Sirawit7205/Autoplanter/20171114_222624.jpg

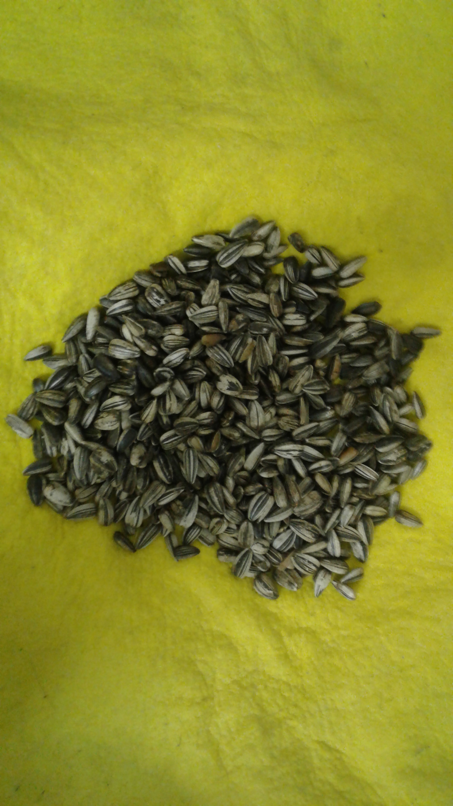
20171114_222624.jpg
