Sirawit7205/Autoplanter/README.md

Autoplanter - Automatic Sunflower Sprout Planter project

For Subject CPE101
