Sirawit7205/Autoplanter/3d_version2/draft2.docx

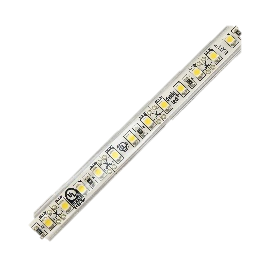
[picture p3: figure]
ผลการค้นหารูปภาพสำหรับ led strip

Water pump

LED strips

Water pipes

User interface & Control box

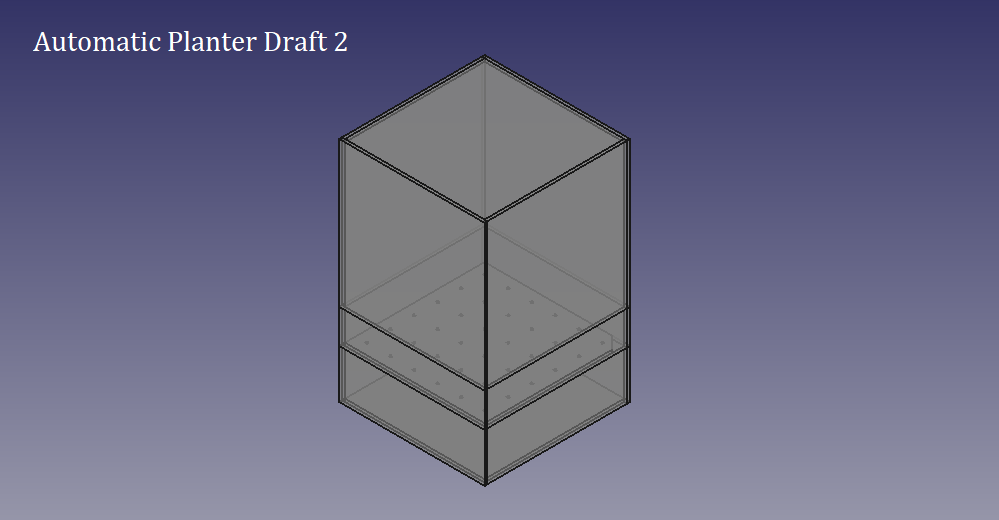
[picture p4: figure]

Water reservoir

Planter tray

Cover

30 cm

30 cm

10 cm

7 cm

30 cm
