Sirawit7205/Autoplanter/exploration3_2.pdf

05/12/60

1

# โครงงาน

## เครือÉ งปลูกต้นอ่อนทานตะวนั

## ·Õè»ÃÖ¡ÉÒ ÊÃÃ ÃÑµ¹ÊÑÒ ¸¹à´ª ÈÃÕÊØ¢ÇÊØ

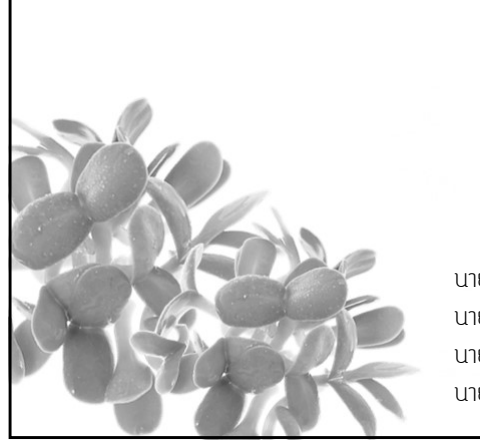
[picture p6: figure]

¹ÒÂÇ§È¸Ã â¡ÊÕÂÐ¡ØÅ | 60070501051
¹ÒÂÀÙÁÔÀÑ·Ã »ÒÅ¡ÐÇ§È ³ ÍÂØ¸ÂÒ 60070501044
¹ÒÂÇÈÔ¹ àÈÃÉ°âª´Ö¡ | 60070501054
¹ÒÂÊÔÃÇÔª ÅÒÀ¾ÔàÈÉ¾Ñ¹¸Ø | 60070501064

# ความเป็นมาและความสาํ คญั ของโครงงาน

## - ÊÔè§ÃÍºµÑÇ

2

## - ¤ÇÒÁÊÒÁÒÃ¶¢Í§ÊÁÒªÔ¡

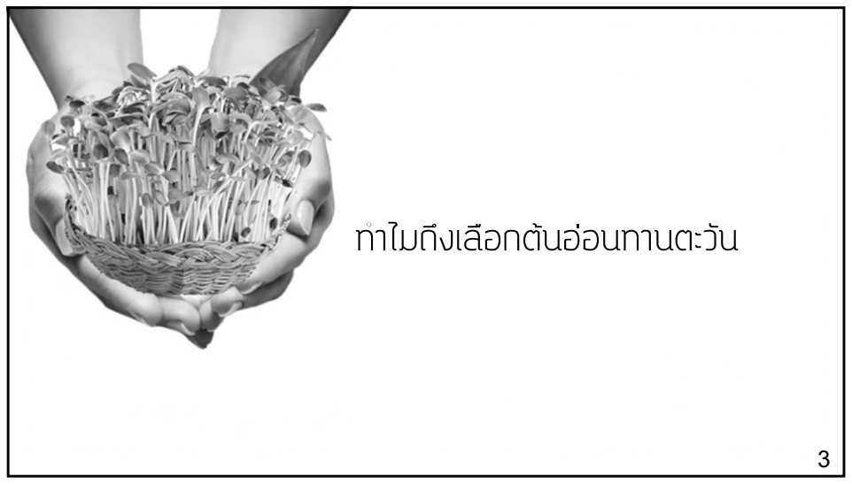
[picture p7: figure]
·íÒäÁ¶Ö§àÅ×Í¡µ ¹Í Í¹·Ò¹µÐÇÑ¹

4

## ÇÔ¸Õ¡ÒÃ»ÅÙ¡µ ¹Í Í¹·Ò¹µÐÇÑ¹·ÑèÇä»

1. áª ¹éíÒà» ¹àÇÅÒ 4-6 ªÁ.

## 2. âÃÂàÁÅç´Å§´¹Ô 3. Ã´¹éíÒÇÑ¹ÅÐ 2 ¤ÃÑé§ àª Ò-àÂç¹

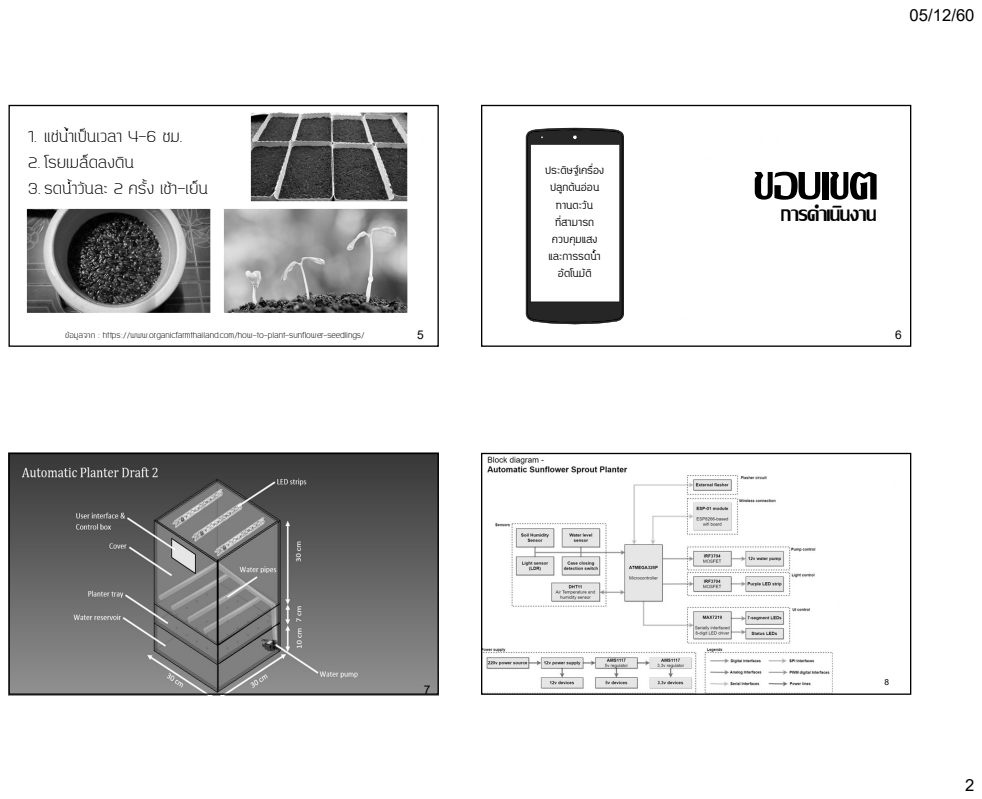
[picture p8: page 2]

ขอบเขต
การดาํ เนนิงาน

·Ò¹µÐÇÑ¹
·ÕèÊÒÁÒÃ¶
¤Çº¤ØÁáÊ§
áÅÐ¡ÒÃÃ´¹éíÒ
ÍÑµâ¹ÁÑµÔ

¢ ÍÁÙÅ¨Ò¡ : https://www.organicfarmthailand.com/how-to-plant-sunflower-seedlings/

3

# คุณลกัษณะของเครองÉื

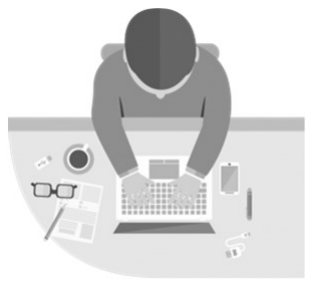
[picture p9: figure]

¡ÒÃÃ´¹Òé ÍÑµâ¹ÁÑµÔ

¤Çº¤ØÁáÊ§
ÍÑµâ¹ÁÑµÔ
9

### ปลูกต้นอ่อนทานตะวนัอตัโนมตัิ

ÇÑ´¤ÇÒÁª×é¹
´Ô¹¡ÑºÍÒ¡ÒÈ

µÃÇ¨ÊÍº ¤ÇÒÁ¼Ô´¾ÅÒ´

¢Í§ÃÐºº | ´ÙÊ¶Ò¹Ð
¼ Ò¹ wifi

# อุปกรณ์

10

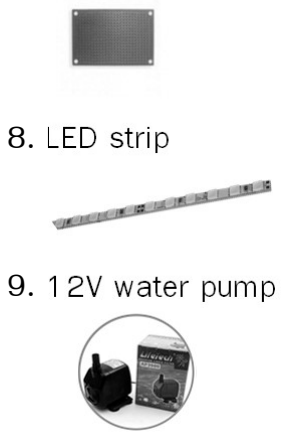
[picture p10: figure]
8. LED strip; 9. 12V water pump

## 1. ATMEGA328P

11

## 2. IRF3704

## 3. DHT111

## 4. ESP-01

## 5. AMS1117

## 6. MAX7219

12

## 7. Phenolic board 10. polycarbonate

## 11. Soil moisture sensor

## 12. Water hose

# ¡ÒÃ´íÒà¹Ô¹¡ÒÃ

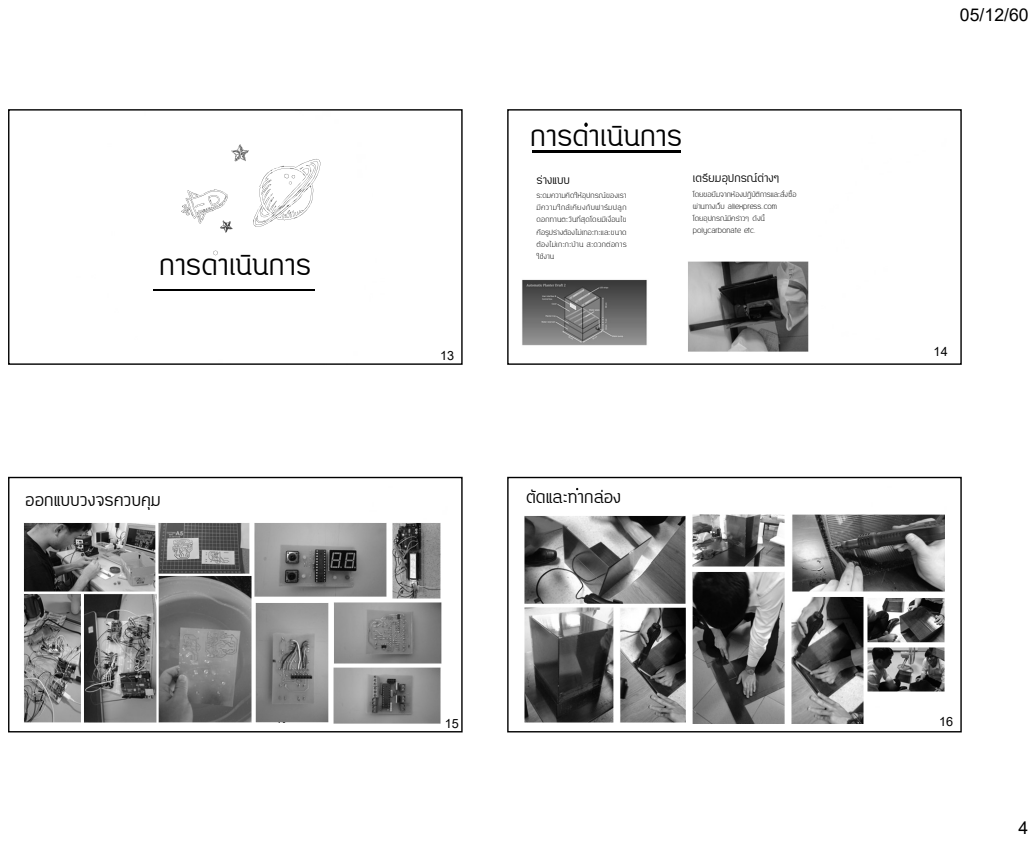
[picture p11: page 4]
ÍÍ¡áººÇ§¨Ã¤Çº¤ØÁ; µÑ´áÅÐ·íÒ¡Å Í§

Ã Ò§áºº
ÃÐ´Á¤ÇÒÁ¤Ô´ãË ÍØ»¡Ã³ ¢Í§àÃÒ
ÁÕ¤ÇÒÁã¡Å à¤ÕÂ§¡Ñº¿ÒÃ Á»ÅÙ¡
´Í¡·Ò¹µÐÇÑ¹·ÕèÊØ´â´ÂÁÕà§×èÍ¹ä¢
¤×ÍÃÙ»Ã Ò§µ Í§äÁ à·ÍÐ·ÐáÅÐ¢¹Ò´

àµÃÕÂÁÍØ»¡Ã³ µ Ò§æ
â´Â¢ÍÂ×Á¨Ò¡Ë Í§»¯®ÔºÑµÔ¡ÒÃáÅÐÊÑè§«×éÍ
¼ Ò¹·Ò§àÇçº aliexpress..com
â´ÂÍØ»¡Ã³ ÁÕ¤Ã ÒÇæ ´Ñ§¹Õé
polycarbonate etc.

¡ÒÃ´íÒà¹Ô¹¡ÒÃ

5

17

## ·´ÅÍ§»ÅÙ¡àÁÅç´·Ò¹µÐÇÑ¹

áººáª ¹éíÒ¡ Í¹áÅ Ç¤ ÍÂàÍÒÅ§´Ô¹ | áººäÁ áª ¹éíÒáÅ ÇàÍÒÅ§´Ô¹

¨Ø´»ÃÐÊ§¤ : • à»ÃÕÂºà·ÕÂº»ÃÐÊÔ·¸ÔÀÒ¾¡ÒÃ»ÅÙ¡µ ¹Í Í¹·Ò¹µÐÇÑ¹ 2 áºº
- à¾×èÍ¹íÒä»»ÃÑºãª ã¹ÃÐºº¡ÒÃ»ÅÙ¡µ ¹Í Í¹·Ò¹µÐÇÑ¹

18

## » ËÒ·Õè¾ºÃÐËÇ Ò§¡ÒÃ·íÒ§Ò¹½/¤ÇÒÁ· Ò·ÒÂ

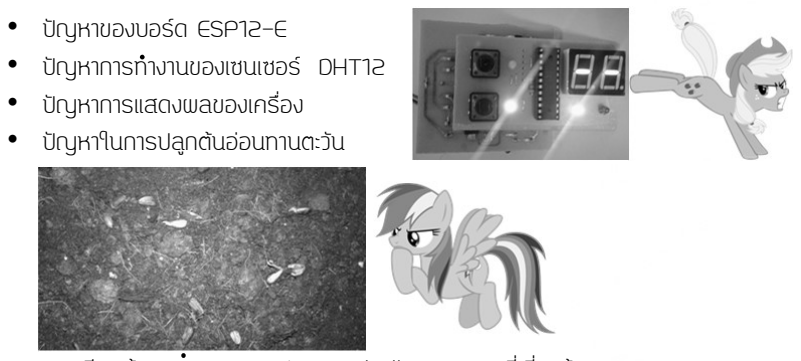
[picture p12: figure]
• » ËÒ¢Í§ºÍÃ ´ ESP12-E • » ËÒ¡ÒÃ·íÒ§Ò¹¢Í§à«¹à«ÍÃ DHT12 • » ËÒ¡ÒÃáÊ´§¼Å¢Í§à¤Ã×èÍ§ • » ËÒã¹¡ÒÃ»ÅÙ¡µ ¹Í Í¹·Ò¹µÐÇÑ¹

- ¡ÒÃàÃÕÂ¹ÃÙ ¡ÒÃ·íÒ§Ò¹¢Í§ microcontroller áÅÐÃÐºº·Õèà¡ÕèÂÇ¢ Í§
- ¤ÇÒÁäÁ ¾Ã ÍÁ¢Í§à¤Ã×èÍ§Á×Í

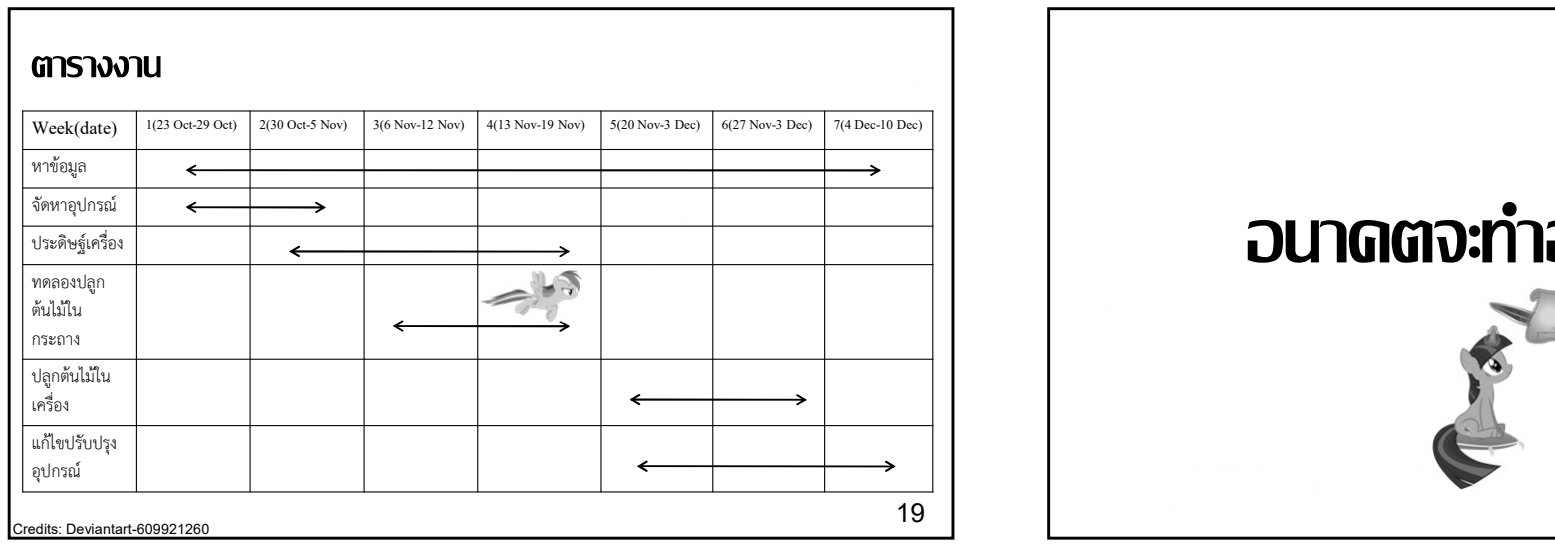
[picture p13: figure]
ตารางงาน; Week(date); 1(23 Oct-29 Oct); 2(30 Oct-5 Nov); 3(6 Nov-12 Nov); 4(13 Nov-19 Nov); 5(20 Nov-3 Dec); 6(27 Nov-3 Dec); 7(4 Dec-10 Dec); หาขอมูล จัดหาอุปกรณ ประดิษฐเครื่อง ทดลองปลูก ตนไมใน กระถาง ปลกูตนไมใน; เครื่อง แกไขปรับปรุง; อุปกรณ Credits: Deviantart-609921260; อนาคตจะทา

# อะไรต่อไป

20
