Sirawit7205/Autoplanter/box_draft1.pdf

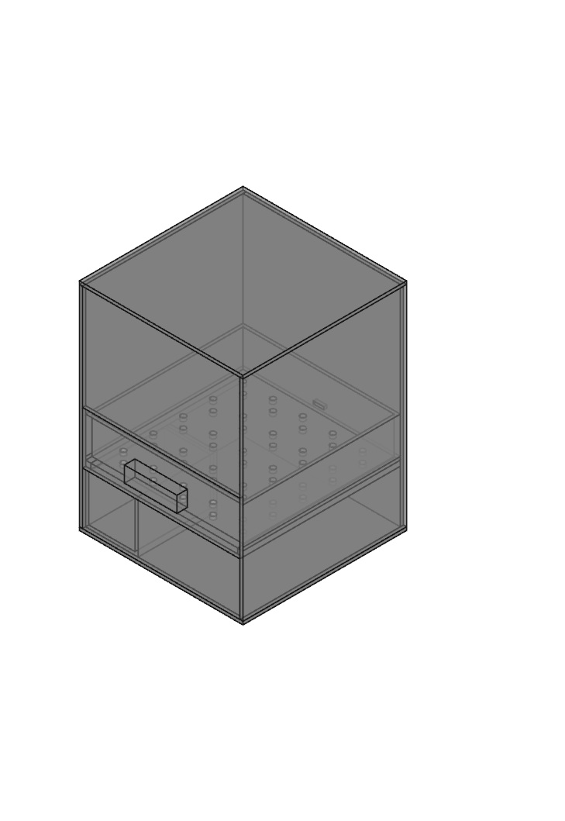
[picture p14: page 1]
