Sirawit7205/Autoplanter/exploration3.pdf

# โครงงาน

# เครื่องปลูกต้นอ่อนทานตะวัน

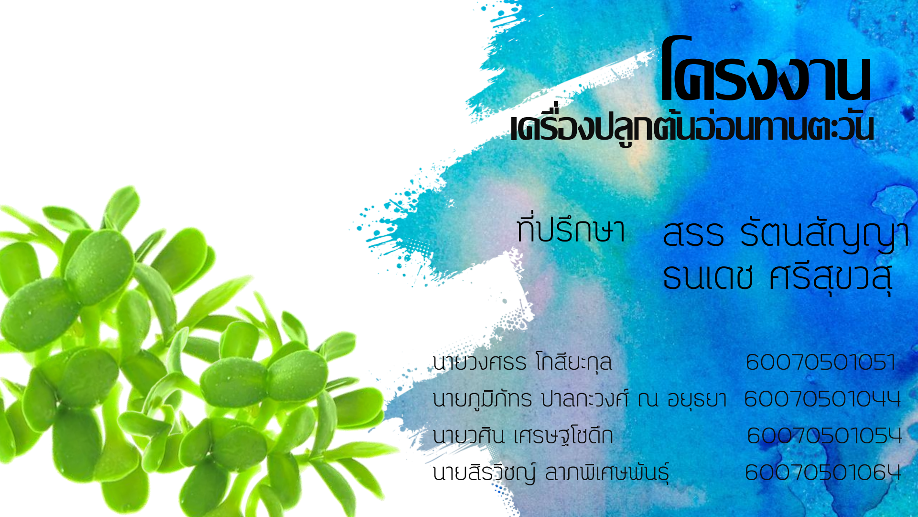
[picture p15: page 1]

## ที่ปรึกษา สรร รัตนสัญญา ธนเดช ศรีสุขวสุ

นายวงศธร โกสียะกุล | 60070501051
นายภูมิภัทร ปาลกะวงศ์ ณ อยุธยา 60070501044
นายวศิน เศรษฐโชดึก | 60070501054
นายสิรวิชญ์ ลาภพิเศษพันธุ์ | 60070501064

# ความเป็นมาและความส าคัญของโครงงาน

## - สิ่งรอบตัว - ความสามารถของสมาชิก

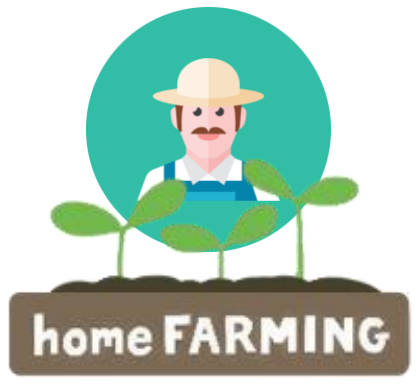
[picture p16: figure]
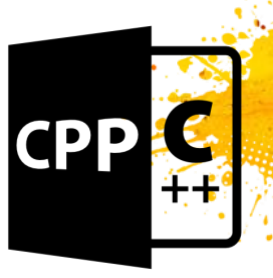
[picture p17: figure]
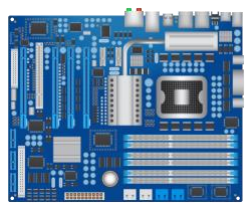
[picture p18: figure]

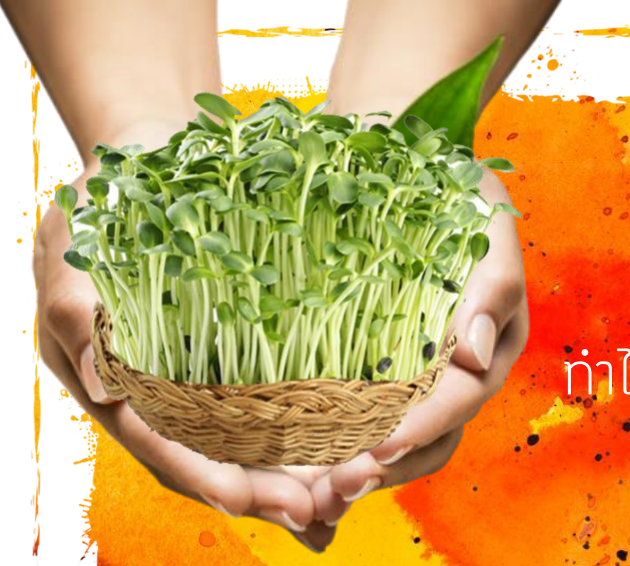
[picture p19: figure]

## ท าไมถึงเลือกต้นอ่อนทานตะวัน

## วิธีการปลูกต้นอ่อนทานตะวันทั่วไป

1. แช่น าเป็นเวลา 4-6 ชม.

## 2. โรยเมล็ดลงดิน

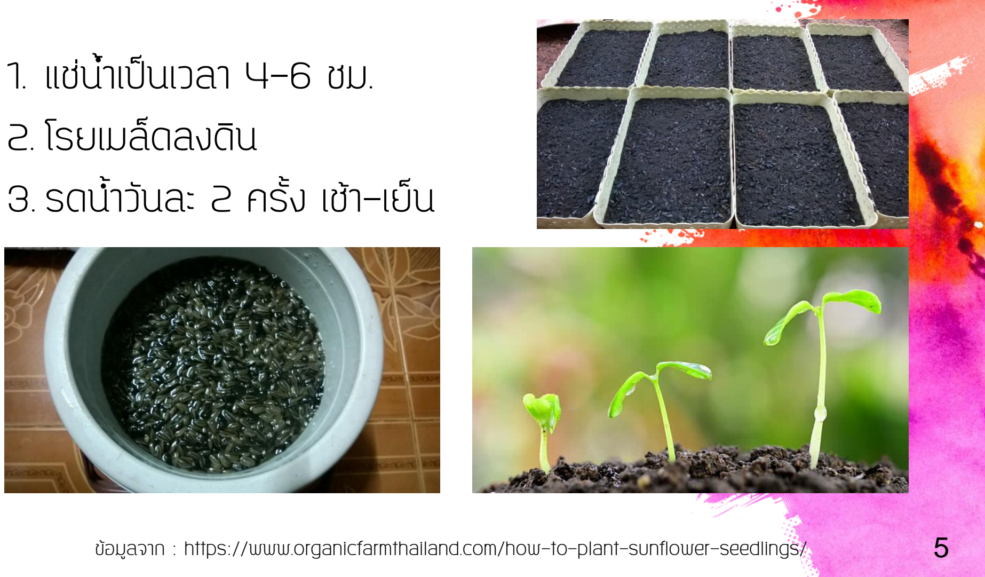
[picture p20: page 5]

## 3. รดน าวันละ 2 ครั ง เช้า-เย็น

ข้อมูลจาก : https://www.organicfarmthailand.com/how-to-plant-sunflower-seedlings/

# ขอบเขต

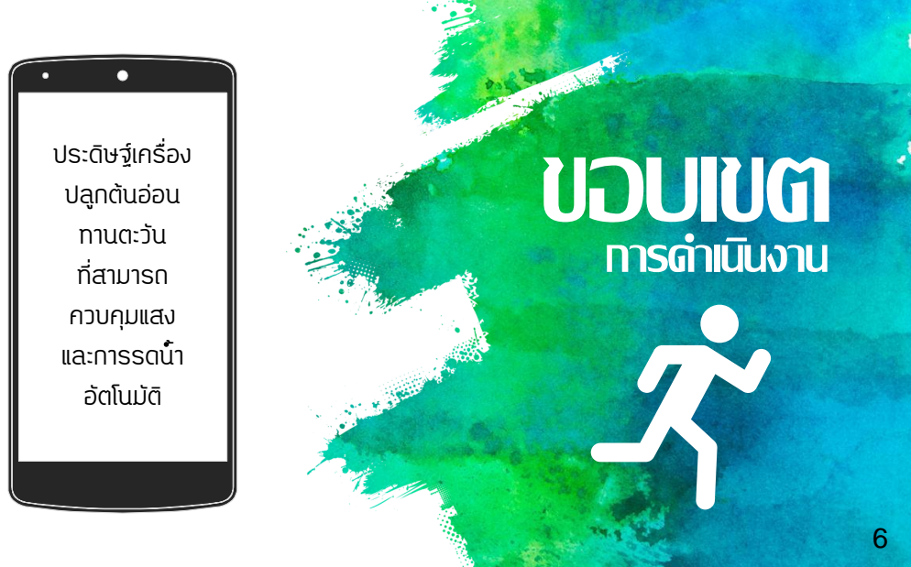
[picture p21: page 6]

ประดิษฐ์เครื่อง
ทานตะวัน
ที่สามารถ
ควบคุมแสง
และการรดน ้า
อัตโนมัติ

การด าเนินงาน

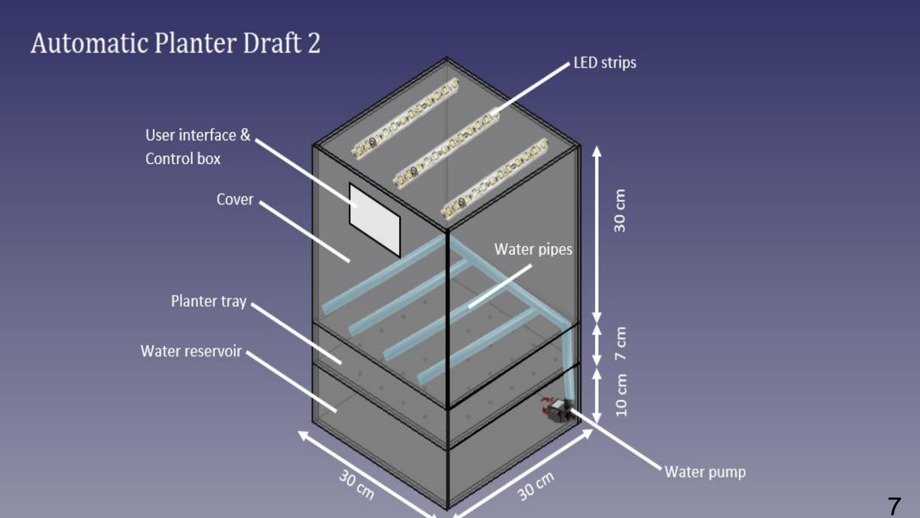
[picture p22: page 7]
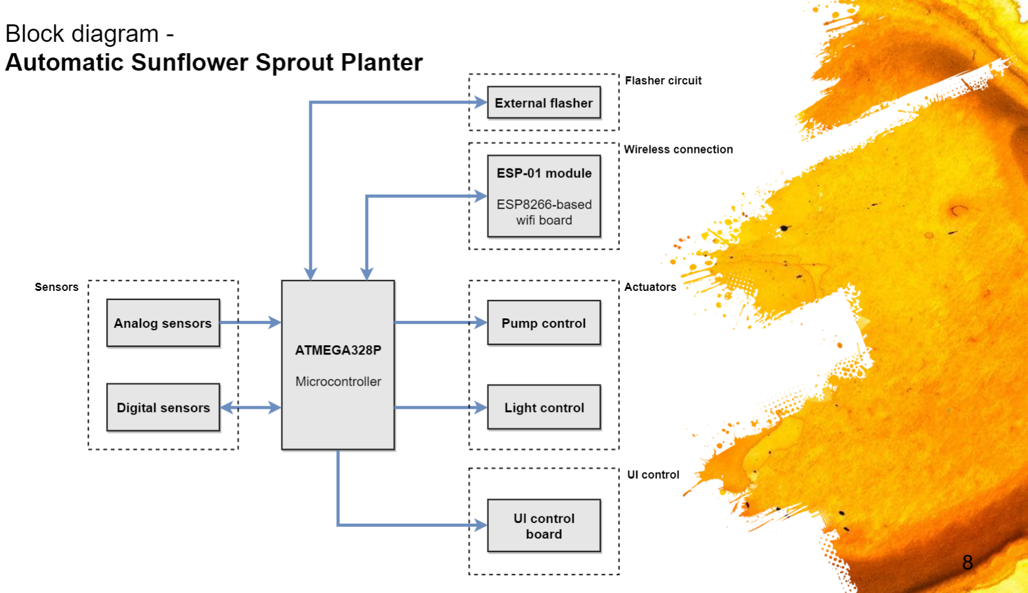
[picture p23: page 8]

# คุณลักษณะของเครื่อง

## ปลูกต้นอ่อนทานตะวันอัตโนมัติ

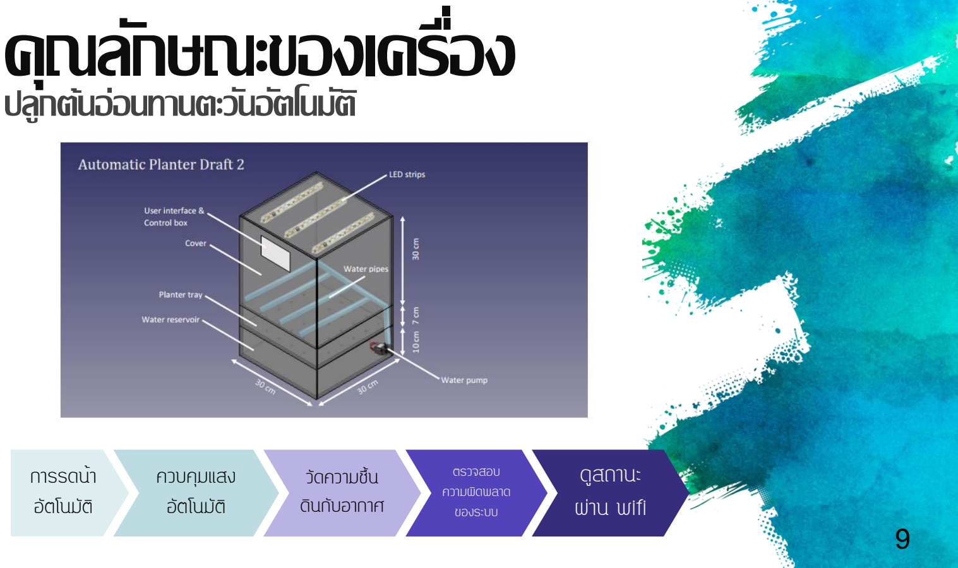
[picture p24: page 9]

การรดน า
อัตโนมัติ

ควบคุมแสง
อัตโนมัติ

วัดความชื น
ดินกับอากาศ

ตรวจสอบ
ความผิดพลาด
ของระบบ

ดูสถานะ
ผ่าน wifi

# อุปกรณ์

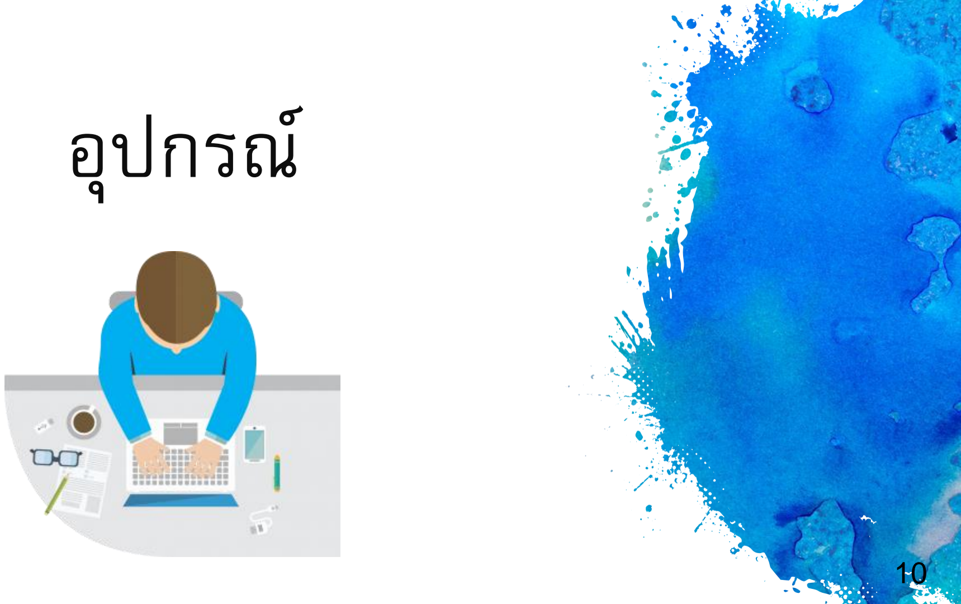
[picture p25: page 10]

### 1. ATMEGA328P

### 4. ESP-01

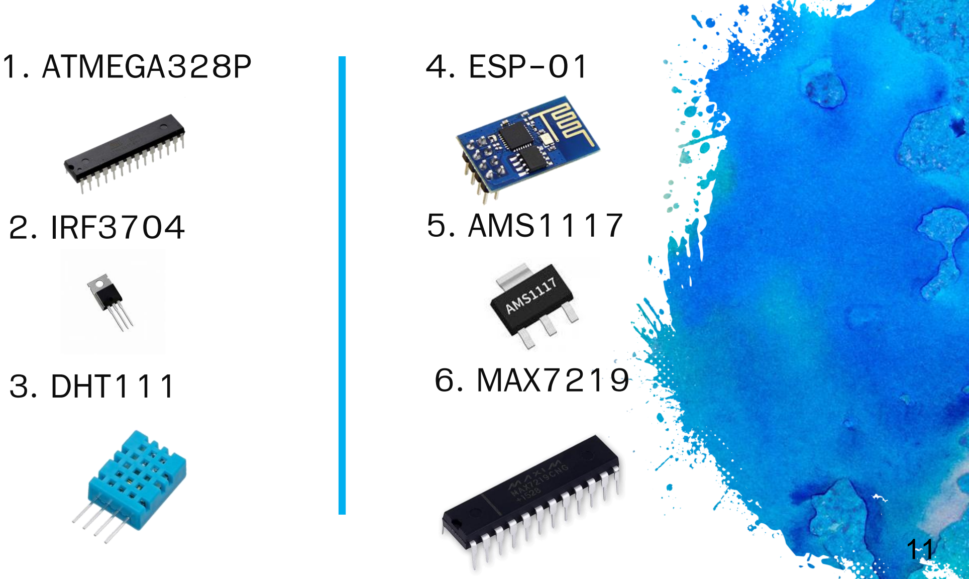
[picture p26: page 11]

### 2. IRF3704

### 3. DHT111

### 5. AMS1117

### 6. MAX7219

### 7. Phenolic board 10. polycarbonate

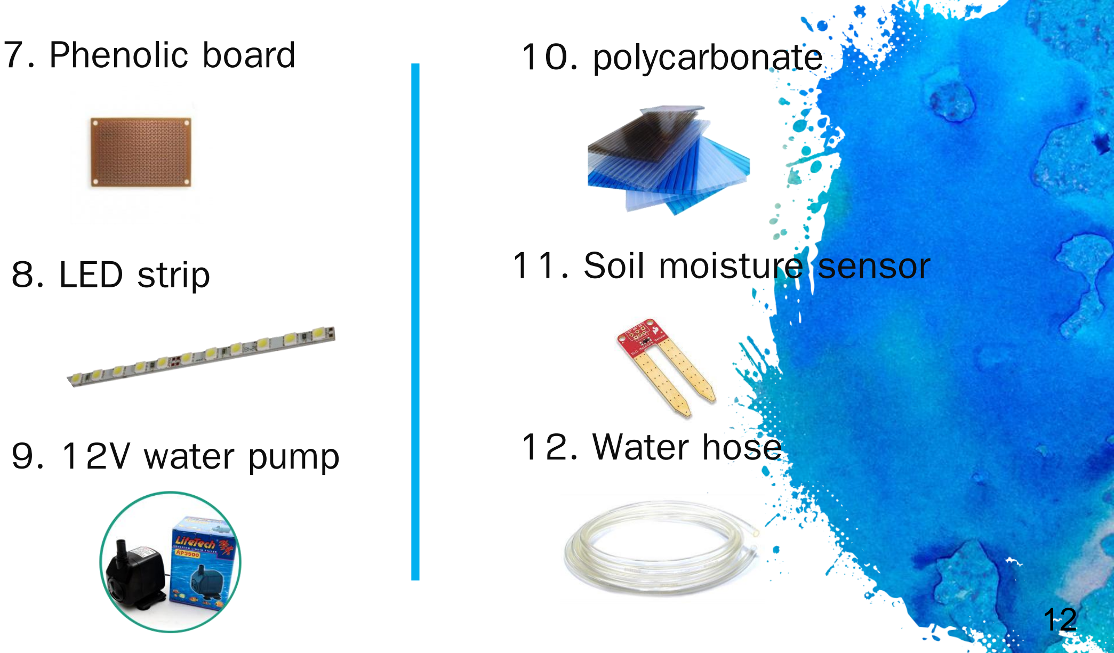
[picture p27: page 12]

### 8. LED strip

### 9. 12V water pump

### 11. Soil moisture sensor

### 12. Water hose

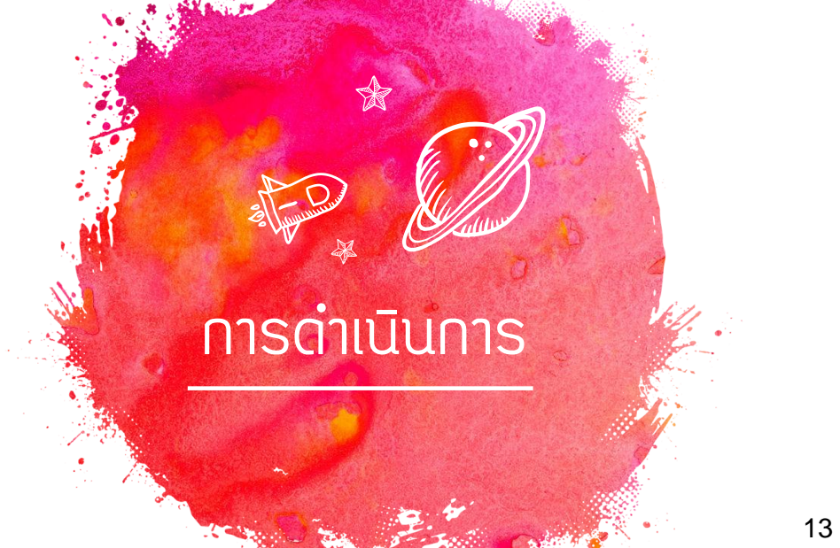
[picture p28: page 13]

การด้าเนินการ

เตรียมอุปกรณ์ต่างๆ

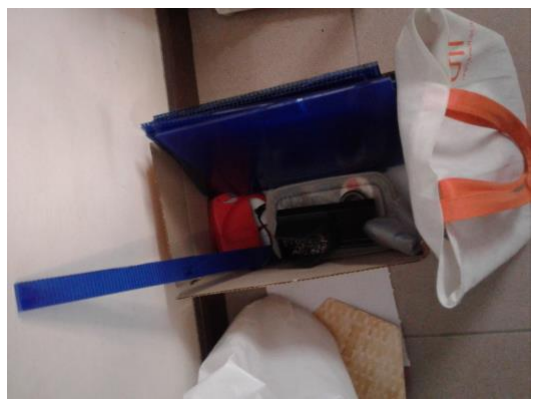
[picture p29: figure]

โดยขอยืมจากห้องปฏฎิบัติการและสั่งซื อ ผ่านทางเว็บ aliexpress..com โดยอุปกรณ์มีคร่าวๆ ดังนี
polycarbonate etc.

ร่างแบบ

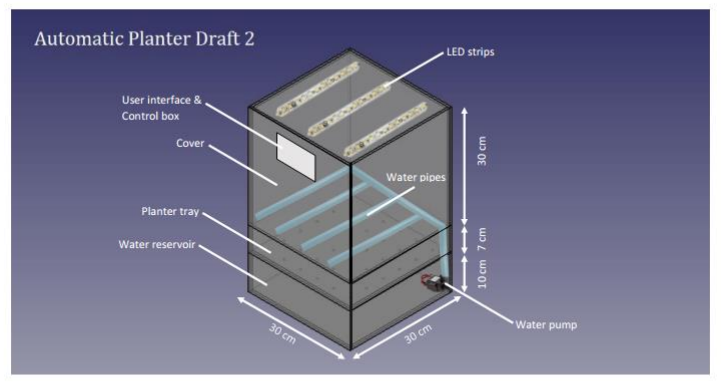
[picture p30: figure]

ระดมความคิดให้อุปกรณ์ของเรา มีความใกล้เคียงกับฟาร์มปลูก ดอกทานตะวันที่สุดโดยมีเงื่อนไข คือรูปร่างต้องไม่เทอะทะและขนาด ต้องไม่เกะกะบ้าน สะดวกต่อการ ใช้งาน

# การด้าเนินการ

## ออกแบบวงจรควบคุม

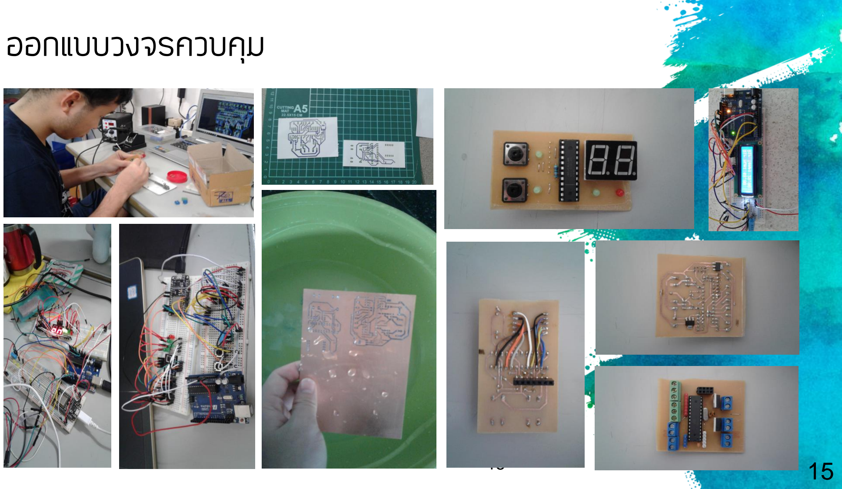
[picture p31: page 15]

15 | 15

## ตัดและท้ากล่อง กล่อง

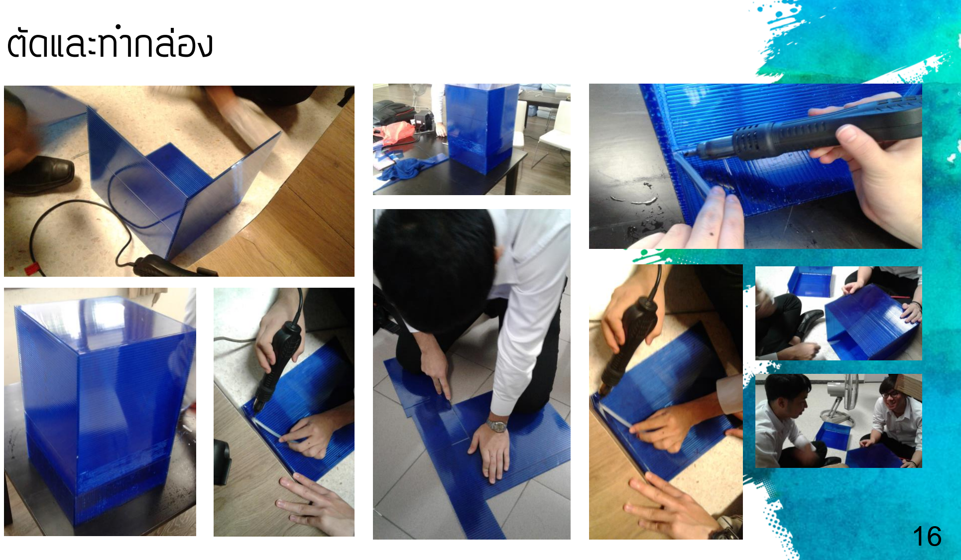
[picture p32: page 16]

## ทดลองปลูกเมล็ดทานตะวัน

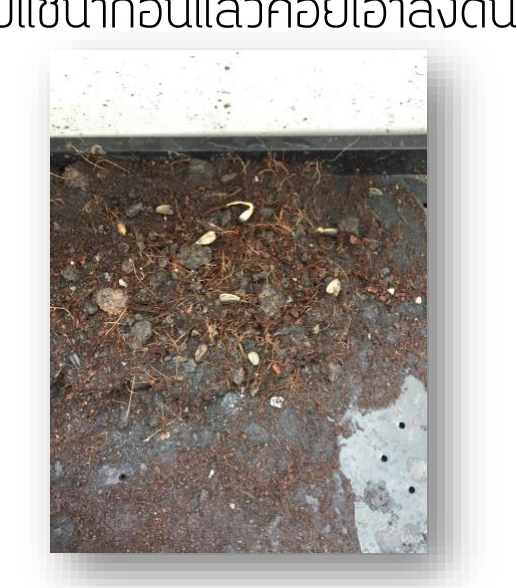
[picture p33: figure]
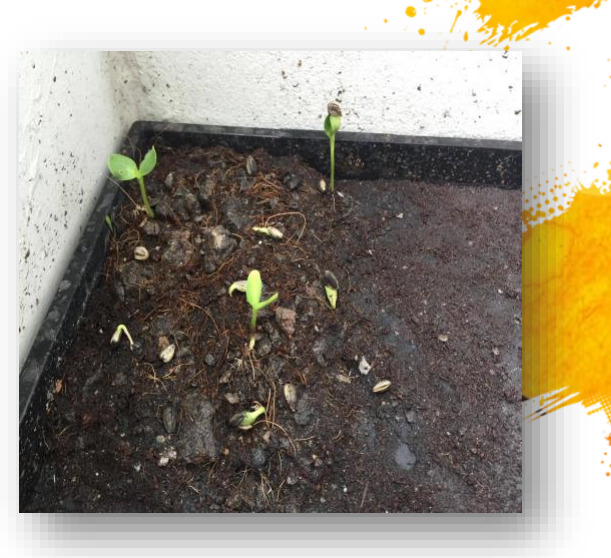
[picture p34: figure]

แบบแช่น าก่อนแล้วค่อยเอาลงดิน | แบบไม่แช่น าแล้วเอาลงดิน

จุดประสงค์ : • เปรียบเทียบประสิทธิภาพการปลูกต้นอ่อนทานตะวัน 2 แบบ
- เพื่อน าไปปรับใช้ในระบบการปลูกต้นอ่อนทานตะวัน

## ปัญหาที่พบระหว่างการท้างานฝ/ความท้าทาย

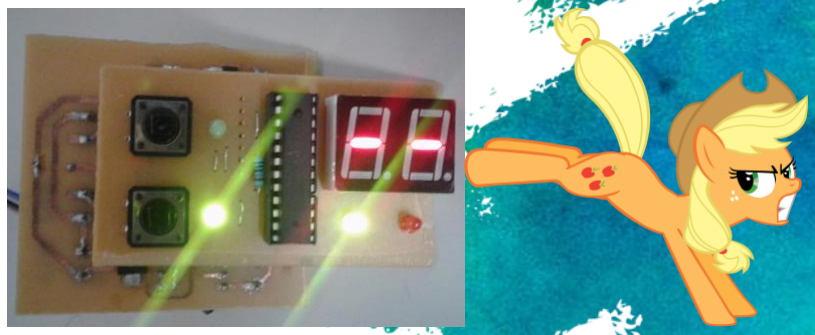
[picture p35: figure]

- ปัญหาของบอร์ด ESP12-E
- ปัญหาการท างานของเซนเซอร์ DHT12
- ปัญหาการแสดงผลของเครื่อง
- ปัญหาในการปลูกต้นอ่อนทานตะวัน

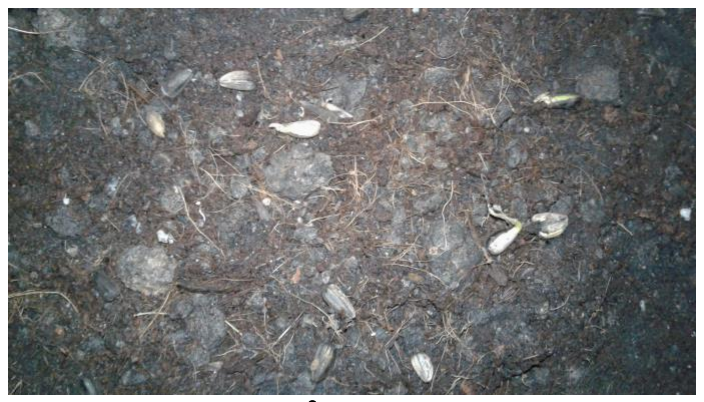
[picture p36: figure]
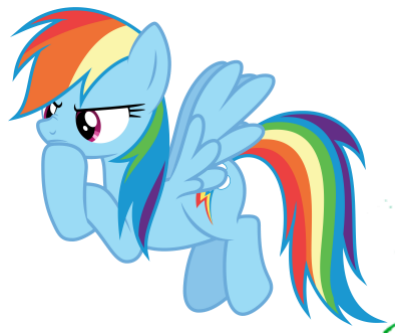
[picture p37: figure]

- การเรียนรู้การท างานของ microcontroller และระบบที่เกี่ยวข้อง
- ความไม่พร้อมของเครื่องมือ

# ตารางงาน

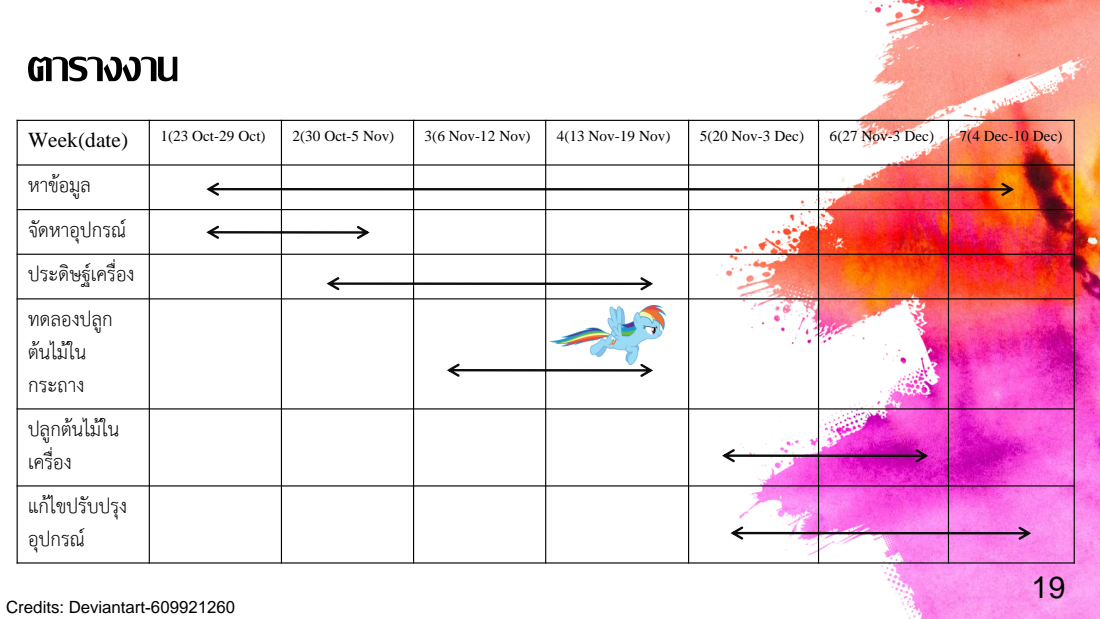
[picture p38: page 19]
Credits: Deviantart-609921260

Week(date) | 1(23 Oct-29 Oct) | 2(30 Oct-5 Nov) | 3(6 Nov-12 Nov) | 4(13 Nov-19 Nov) | 5(20 Nov-3 Dec) | 6(27 Nov-3 Dec) | 7(4 Dec-10 Dec)
หาข้อมูล
จัดหาอุปกรณ์
ประดิษฐ์เครื่อง
ทดลองปลูก ต้นไม้ใน กระถาง

ปลูกต้นไม้ใน เครื่อง

แก้ไขปรับปรุง อุปกรณ์

# อนาคตจะท าอะไรต่อไป

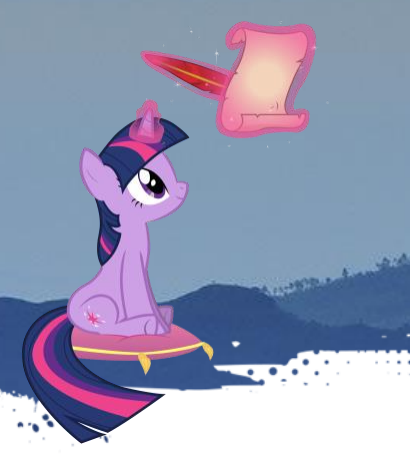
[picture p39: figure]
