Sirawit7205/Autoplanter/3Ddraft1.png

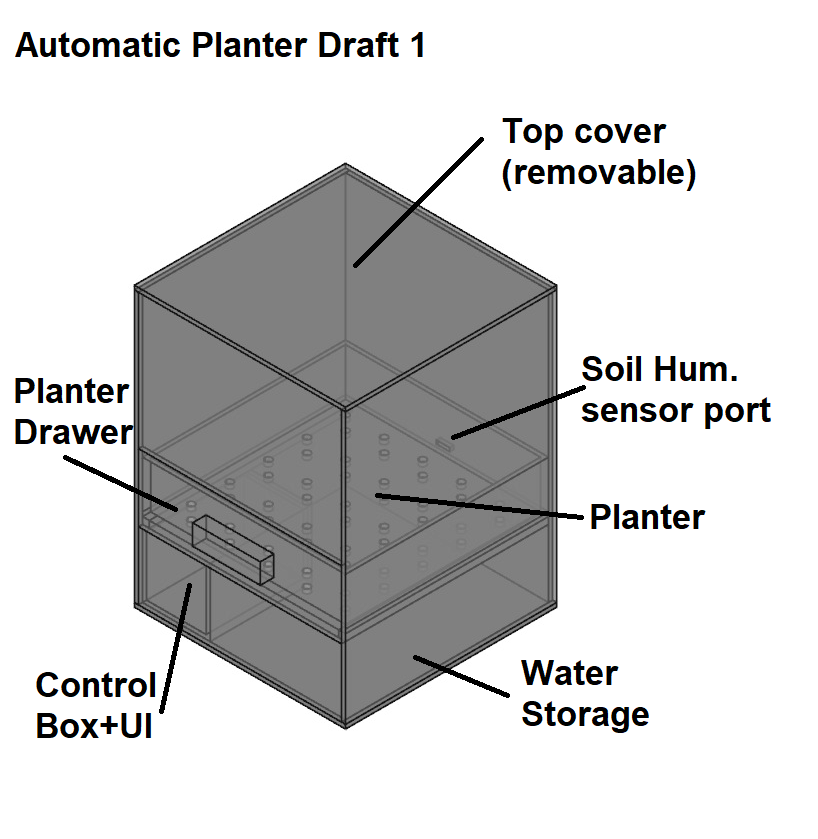
3Ddraft1.png
