Sirawit7205/Autoplanter/7seg.png

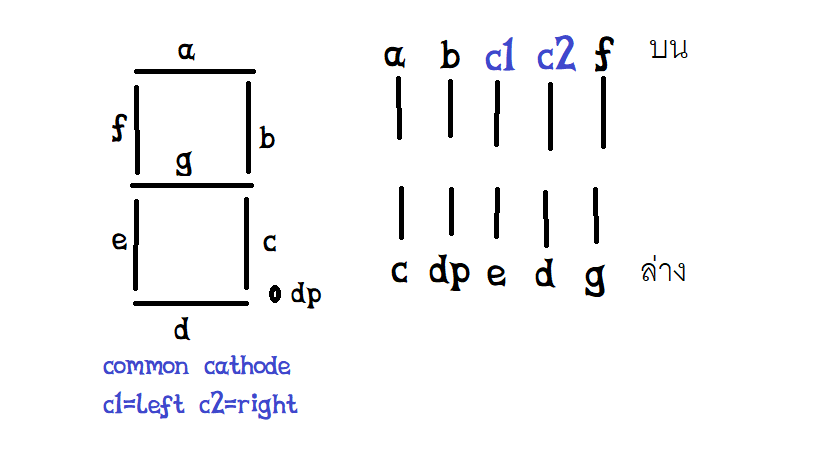
7seg.png
