Sirawit7205/Autoplanter/board v1.2 1.PNG

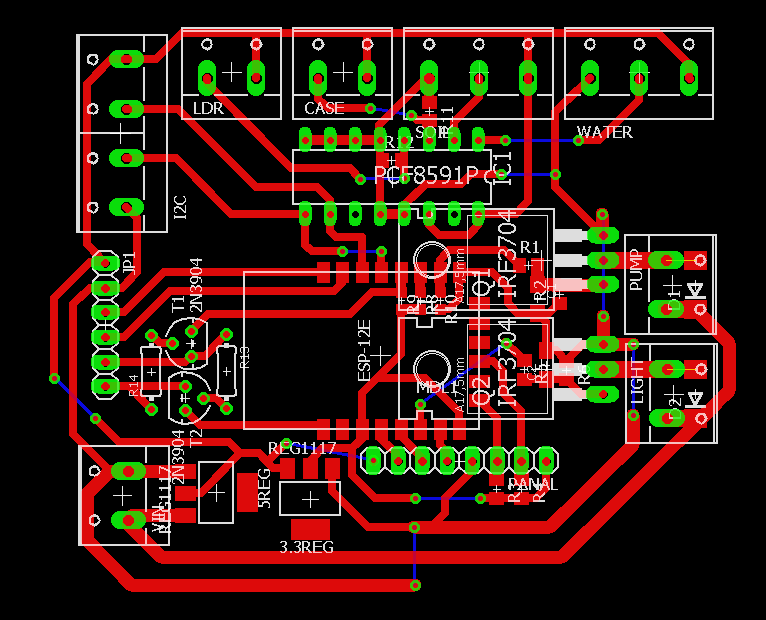
board v1.2 1.PNG
