Sirawit7205/Autoplanter/fuzzy.jpg

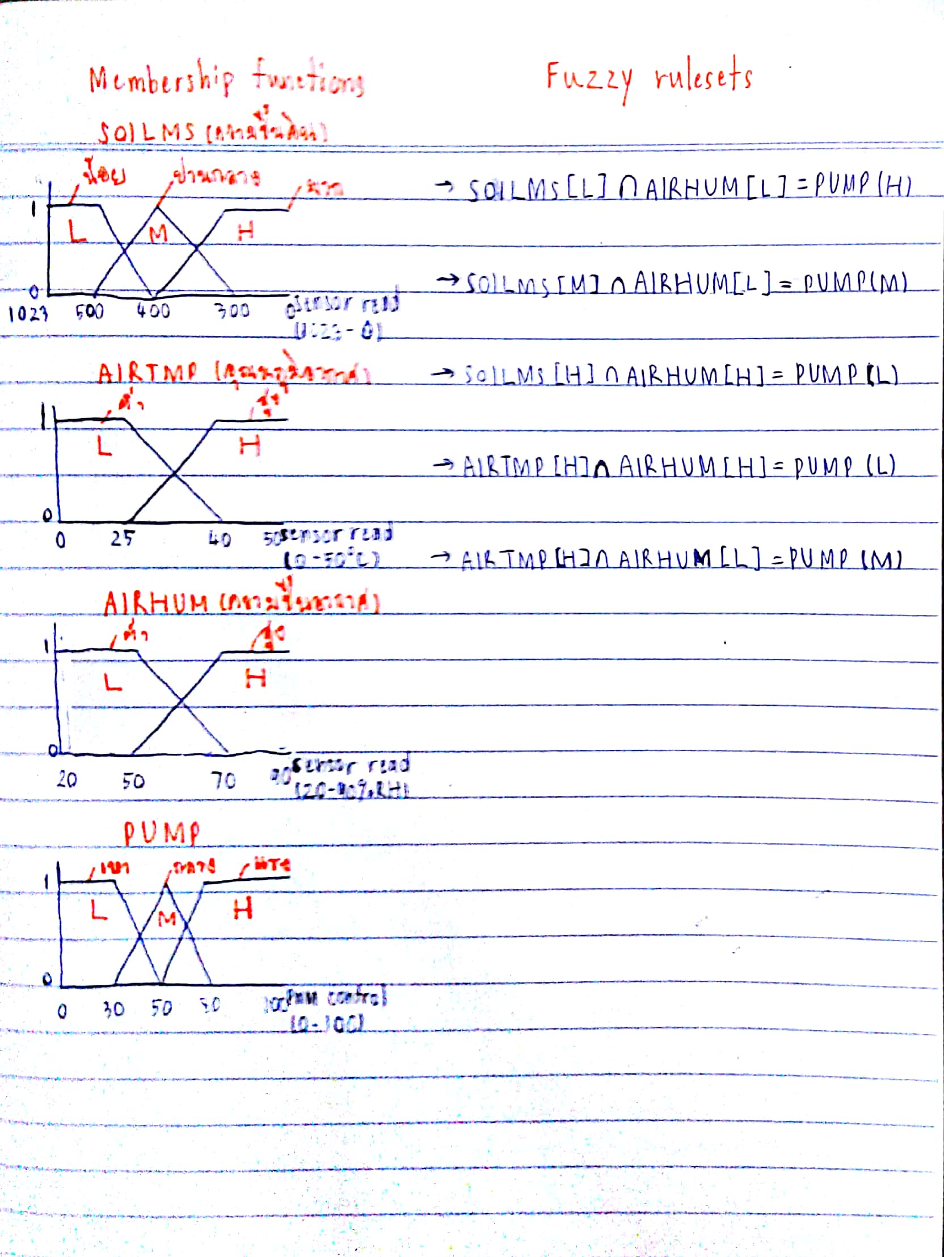
fuzzy.jpg
