Sirawit7205/Autoplanter/pictures/flashDetails4Mbit.png

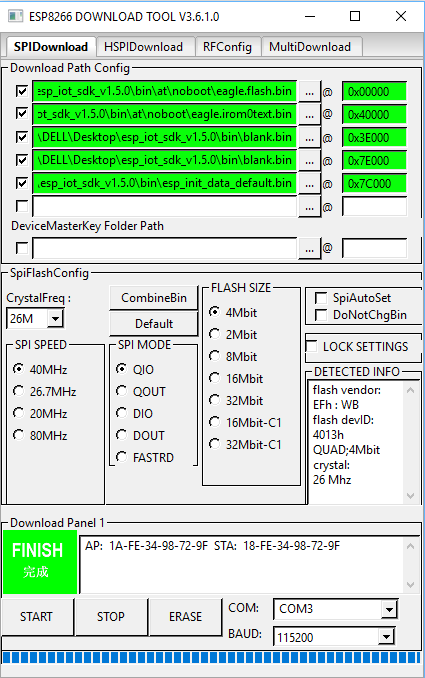
pictures/flashDetails4Mbit.png
