Sirawit7205/Autoplanter/pictures/flashDetails8Mbit.png

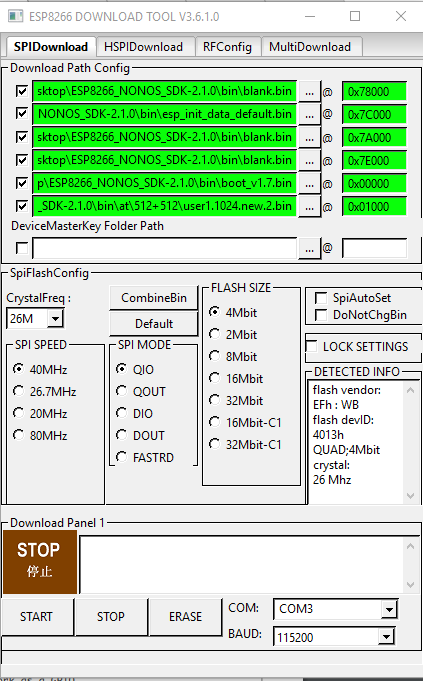
pictures/flashDetails8Mbit.png
