Sirawit7205/Autoplanter/pictures/monitor.png

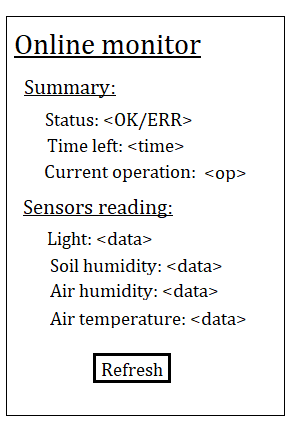
pictures/monitor.png
