Sirawit7205/Autoplanter/sch4.PNG

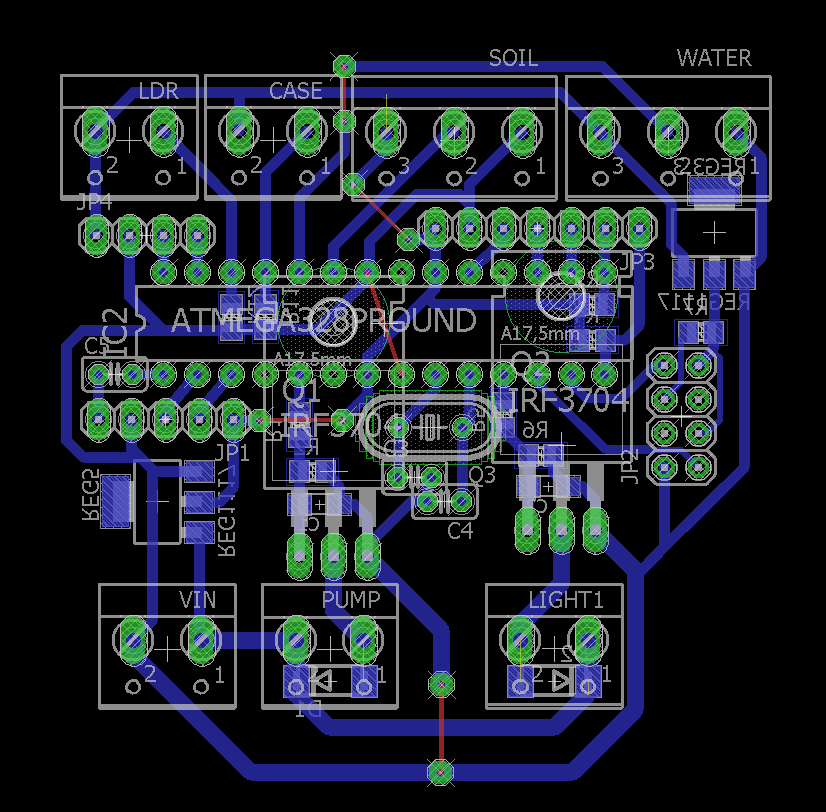
sch4.PNG
