Sirawit7205/Autoplanter/sch all.PNG

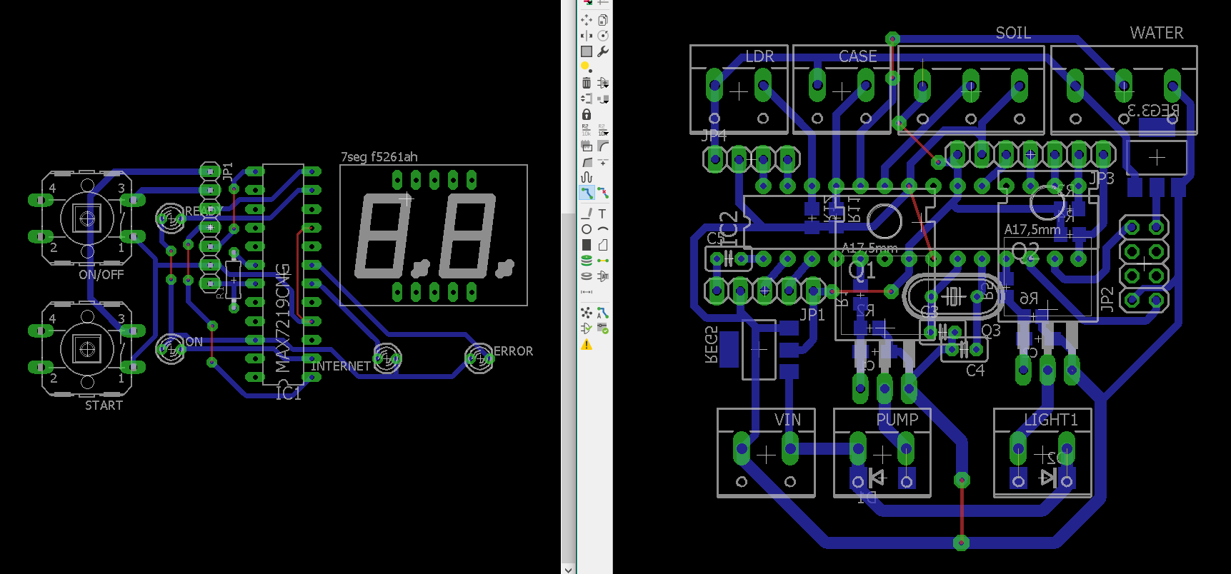
sch all.PNG
