Sirawit7205/Autoplanter/sch ver1.2 1.PNG

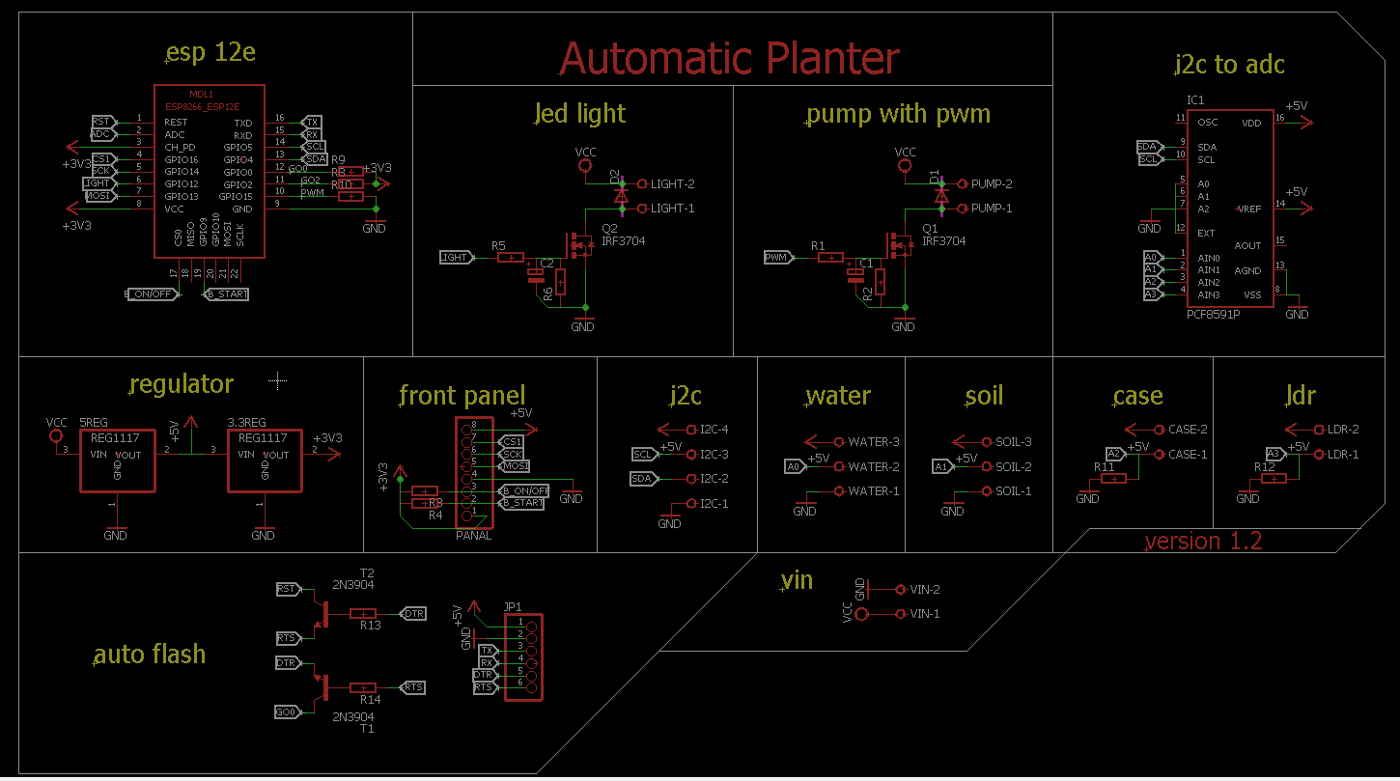
sch ver1.2 1.PNG
