Sirawit7205/Autoplanter/sch ver 1.20/SCH_IO_black.png

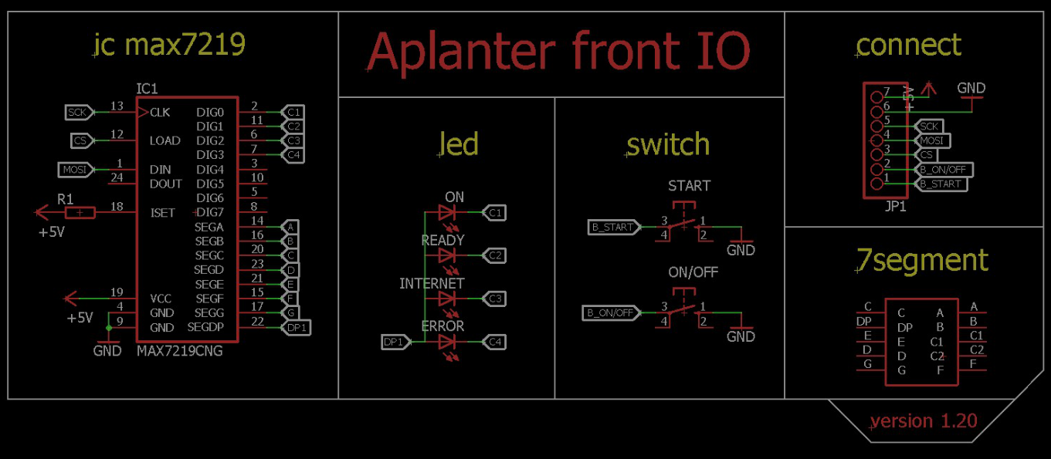
sch ver 1.20/SCH_IO_black.png
