Sirawit7205/Autoplanter/sch ver 1.20/SCH_IO_white.png

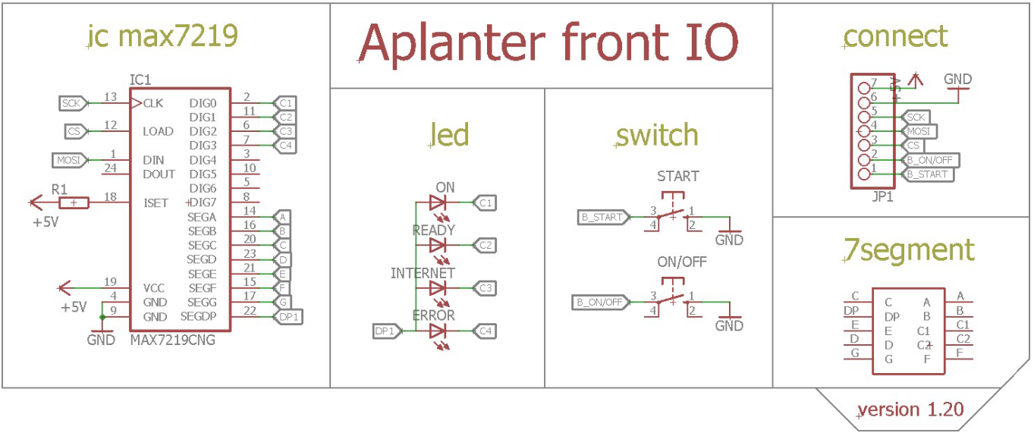
sch ver 1.20/SCH_IO_white.png
