Sirawit7205/Autoplanter/sch ver 1.20/SCH_main_black.png

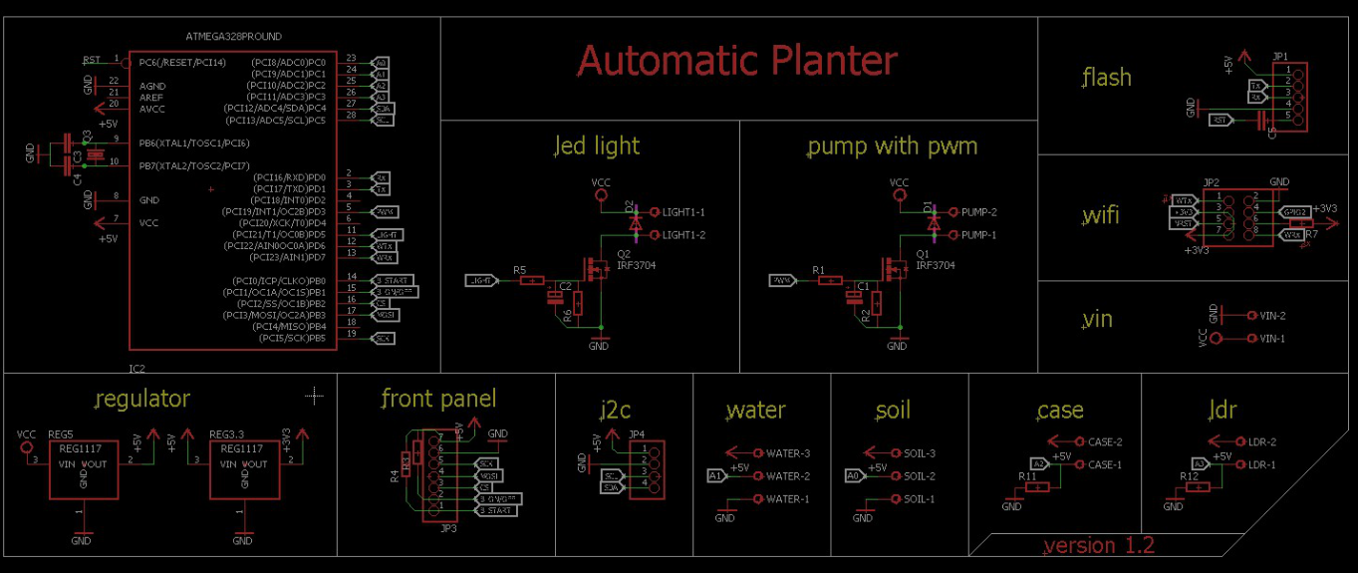
sch ver 1.20/SCH_main_black.png
