Sirawit7205/Autoplanter/UIdraft1.png

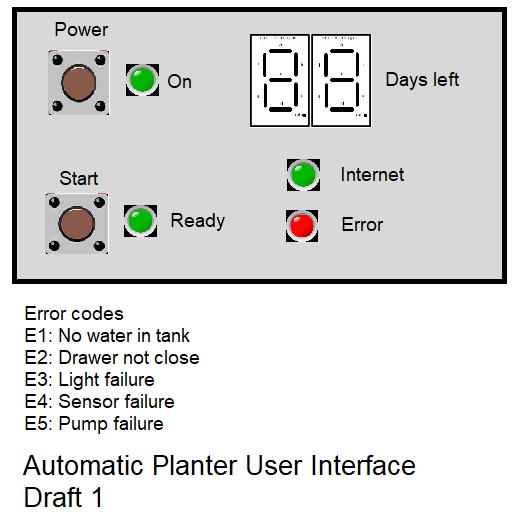
UIdraft1.png
