Sirawit7205/Autoplanter/UIDraft2.png

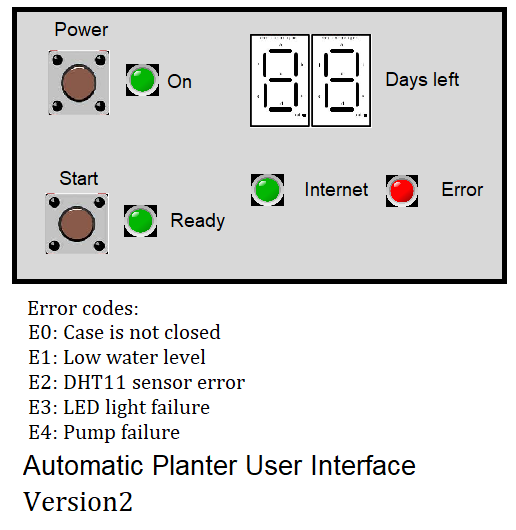
UIDraft2.png
