Sirawit7205/Autoplanter/complete.FCStd

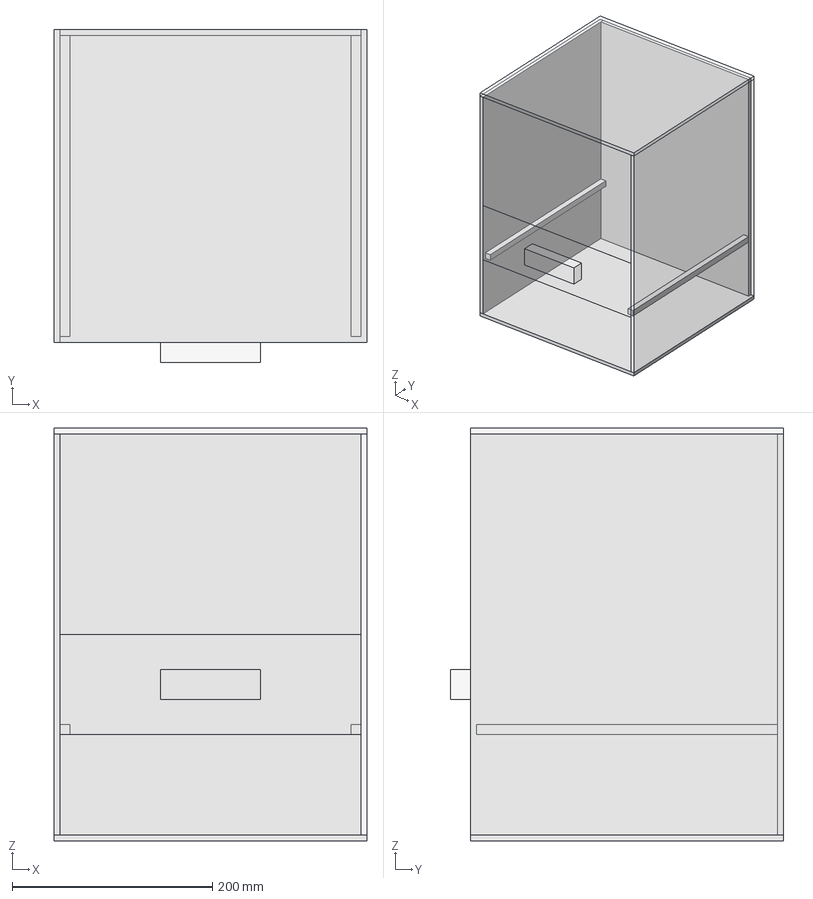
[picture p59: CAD file, 2017-11-29]
complete.FCStd
312.0 x 332.0 x 412.0 mm
base_top_01
side_01
side_02
back_01
base_top_02
front_base_01
drawing_rail_01
drawing_rail_02
drawer_01
front_top_01
