Sirawit7205/Autoplanter/3d_version2/assemV2.FCStd

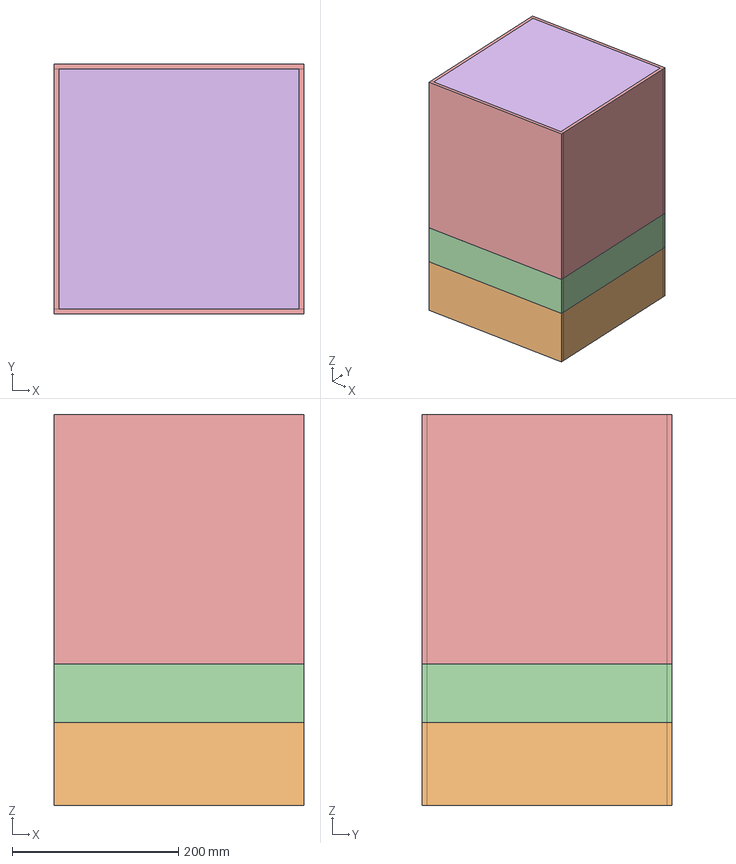
[picture p60: CAD file, 2017-11-29]
3d_version2/assemV2.FCStd
300.0 x 300.0 x 470.0 mm
base_01
level1_01
tray_01
level2_01
level3_01
base_02
