Sirawit7205/Autoplanter/drawer.FCStd

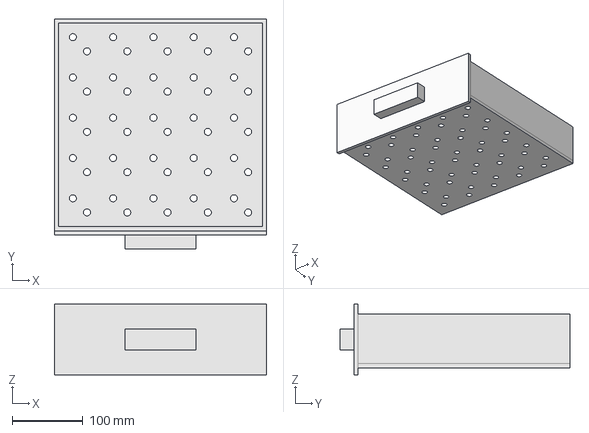
[picture p61: CAD file, 2017-11-29]
drawer.FCStd
300.0 x 326.0 x 100.0 mm
