Sirawit7205/Autoplanter/3d_version2/tray.FCStd

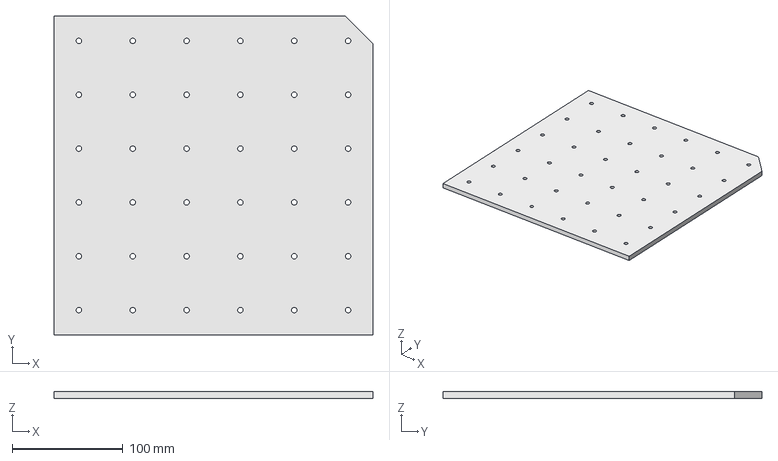
[picture p62: CAD file, 2017-11-29]
3d_version2/tray.FCStd
288.0 x 288.0 x 6.00 mm
