Sirawit7205/Autoplanter/3d_version2/level1.FCStd

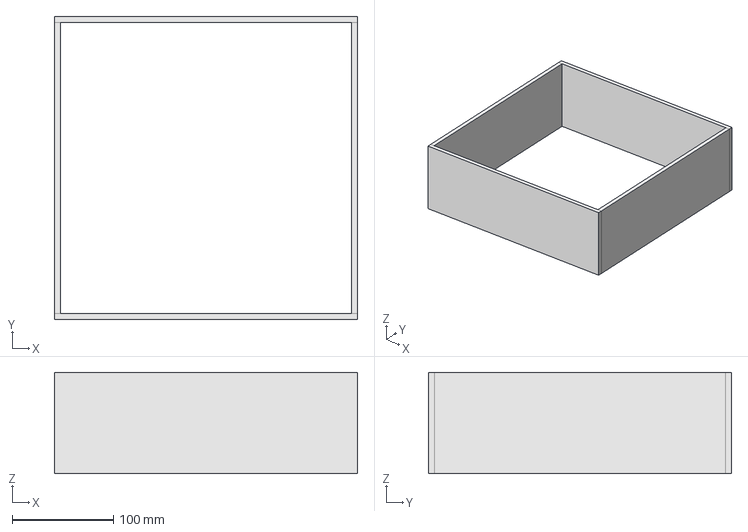
[picture p63: CAD file, 2017-11-29]
3d_version2/level1.FCStd
300.0 x 300.0 x 100.0 mm
