Sirawit7205/Autoplanter/side.FCStd

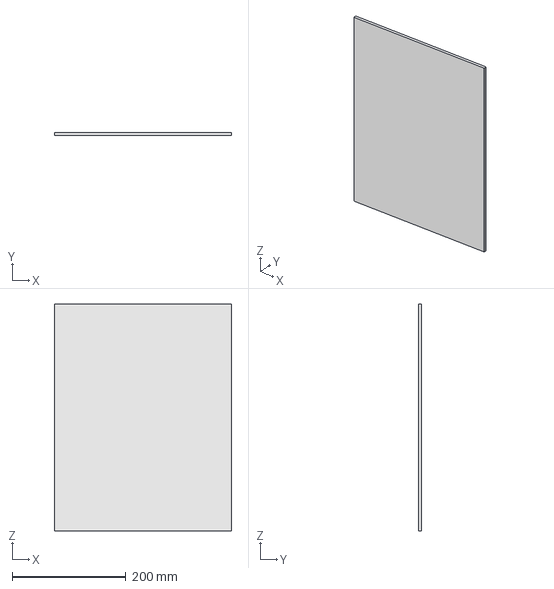
[picture p64: CAD file, 2017-11-29]
side.FCStd
312.0 x 6.00 x 400.0 mm
