Sirawit7205/Autoplanter/3d_version2/level2.FCStd

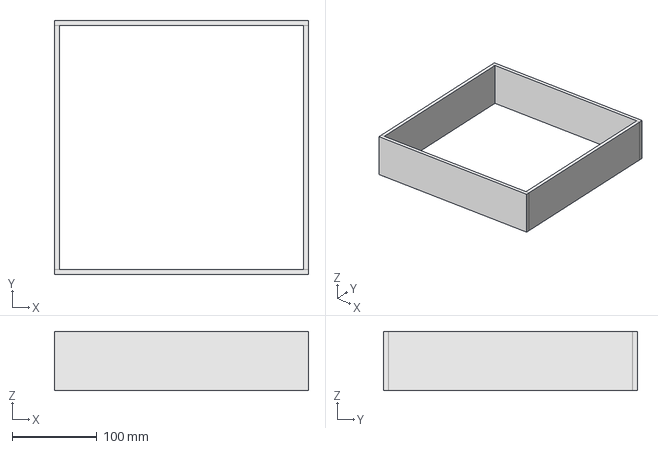
[picture p65: CAD file, 2017-11-29]
3d_version2/level2.FCStd
300.0 x 300.0 x 70.0 mm
