Sirawit7205/Autoplanter/tutorial.FCStd

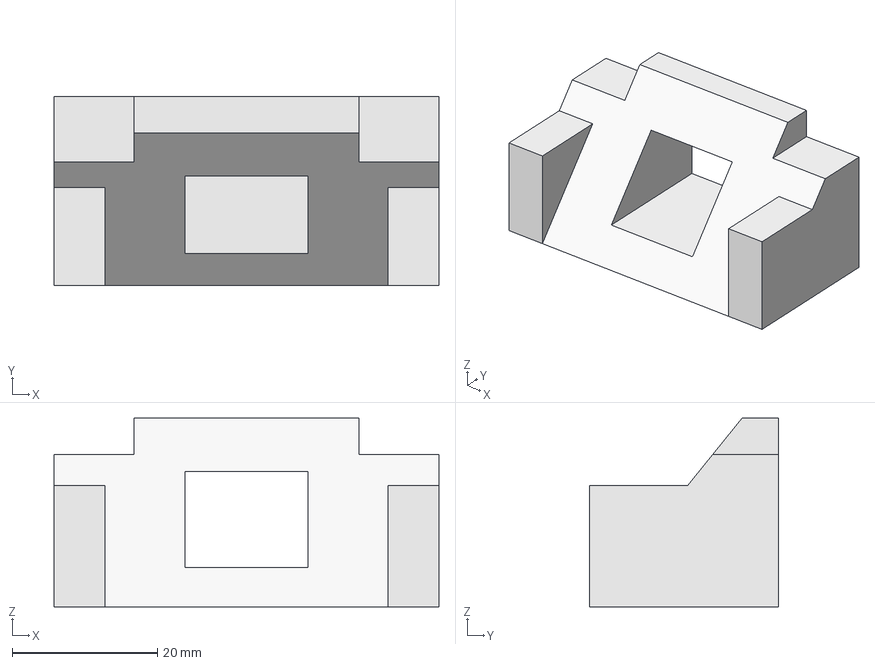
[picture p66: CAD file, 2017-11-29]
tutorial.FCStd
53.0 x 26.0 x 26.0 mm
