Sirawit7205/Autoplanter/3d_version2/level3.FCStd

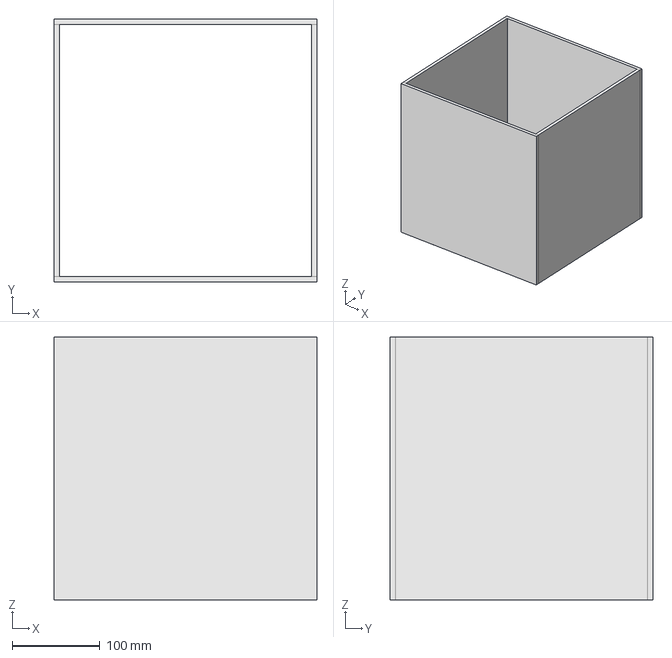
[picture p67: CAD file, 2017-11-29]
3d_version2/level3.FCStd
300.0 x 300.0 x 300.0 mm
