Sirawit7205/Autoplanter/back.FCStd

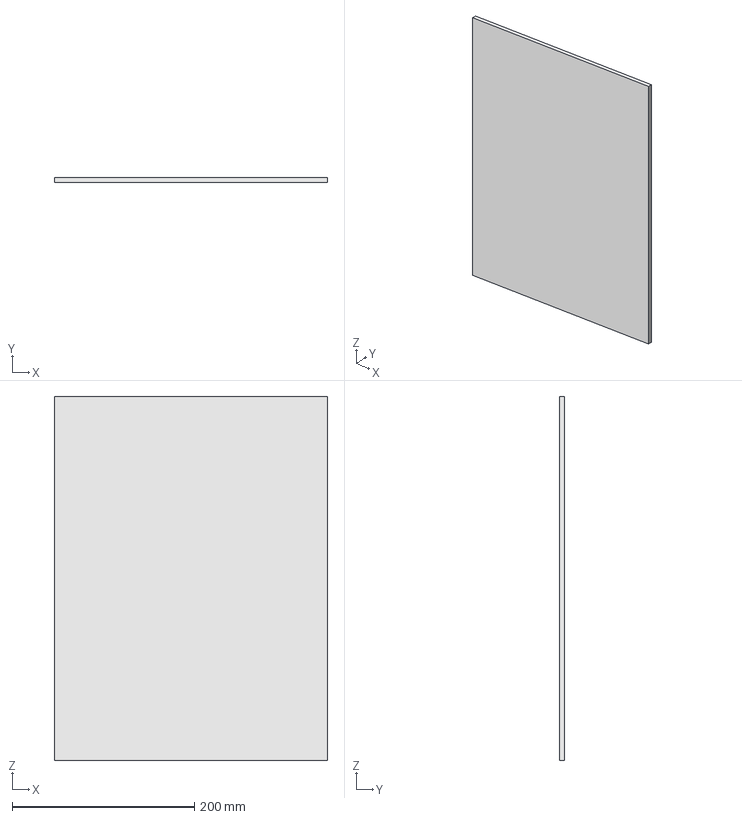
[picture p68: CAD file, 2017-11-29]
back.FCStd
300.0 x 6.00 x 400.0 mm
