Sirawit7205/Autoplanter/front_base.FCStd

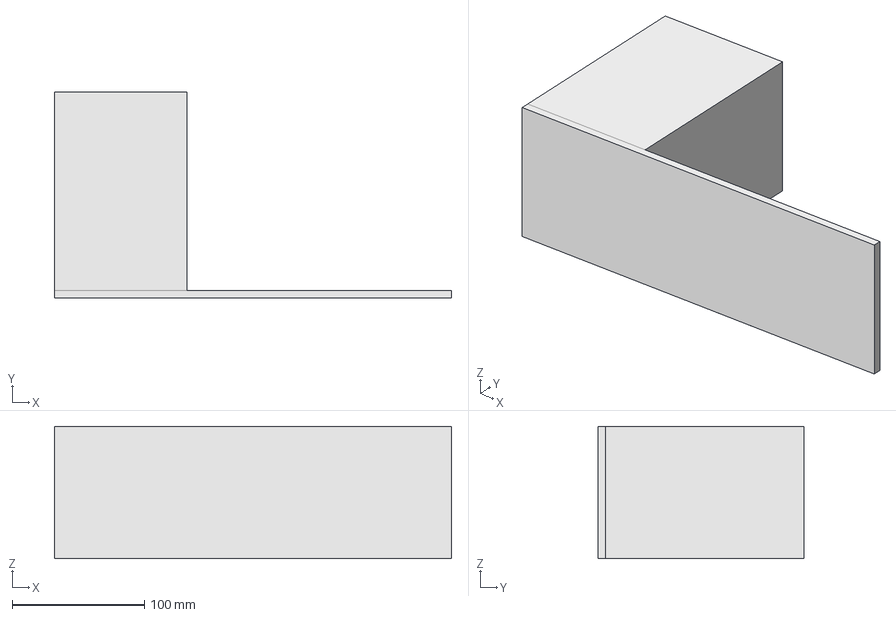
[picture p69: CAD file, 2017-11-29]
front_base.FCStd
300.0 x 156.0 x 100.0 mm
