Sirawit7205/Autoplanter/front_top.FCStd

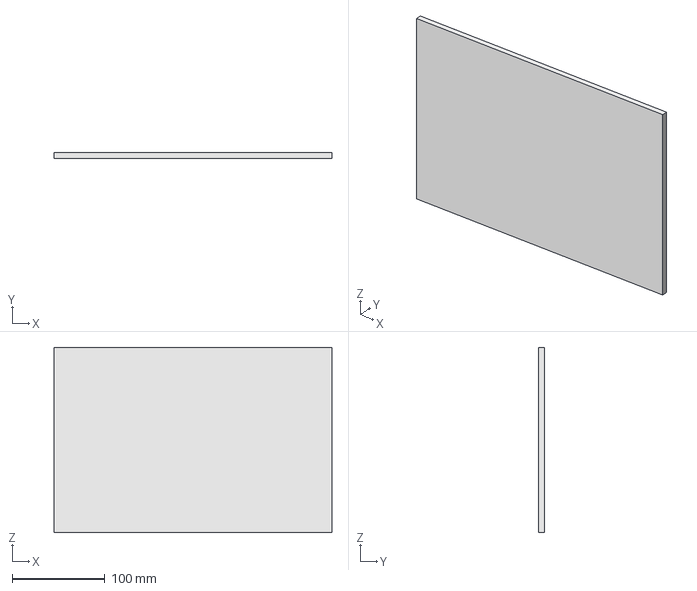
[picture p70: CAD file, 2017-11-29]
front_top.FCStd
300.0 x 6.00 x 200.0 mm
