Sirawit7205/Autoplanter/drawing_rail.FCStd

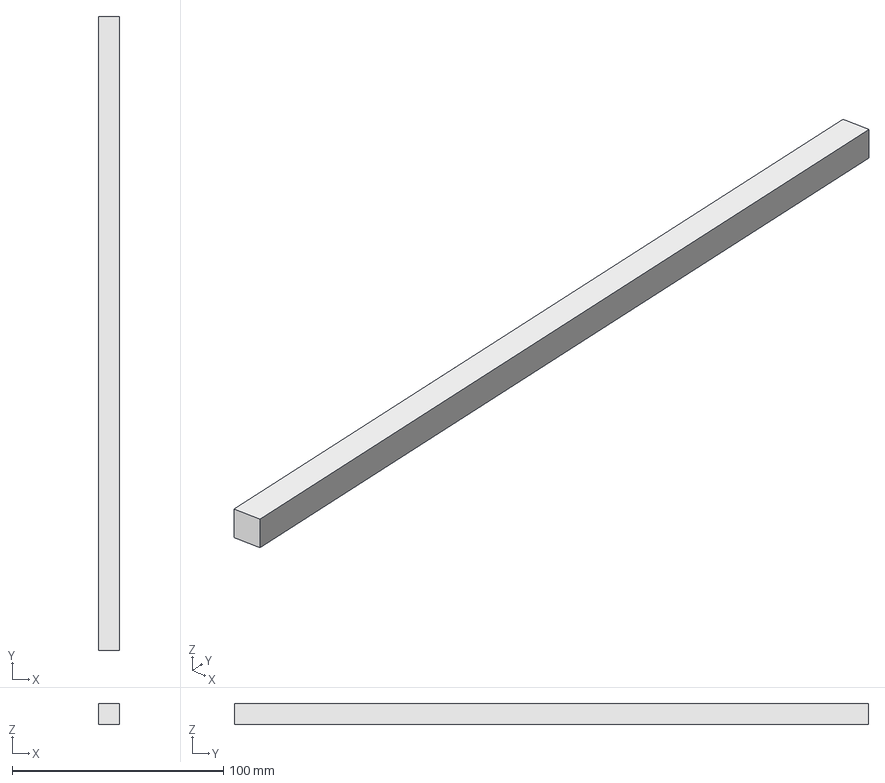
[picture p71: CAD file, 2017-11-29]
drawing_rail.FCStd
10.0 x 300.0 x 10.0 mm
