Sirawit7205/Autoplanter/base_top.FCStd

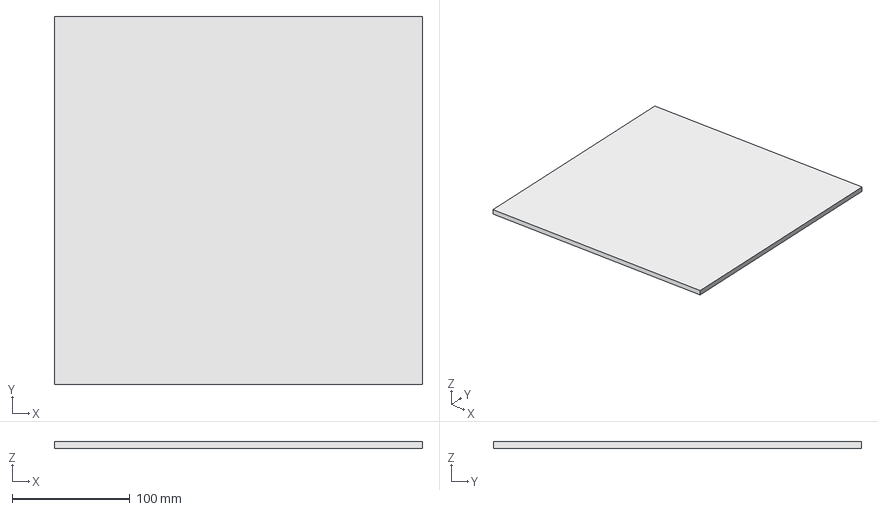
[picture p72: CAD file, 2017-11-29]
base_top.FCStd
312.0 x 312.0 x 6.00 mm
