Sirawit7205/Autoplanter/(list of files, cad)

Other CAD files:
3d_version2/base.FCStd
