Sirawit7205/Autoplanter/pictures/setup.png

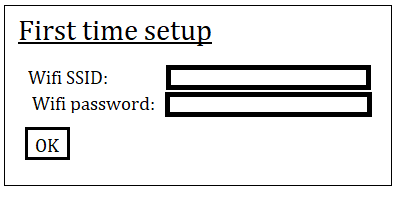
pictures/setup.png
