Sirawit7205/Autoplanter/measurement_1week.xlsx

Day/time | 1/Morning | 1/Evening | 2/Morning | 2/Evening | 3/Morning | 3/Evening | 4/Morning | 4/Evening | 5/Morning | 5/Evening | 6/Morning | 6/Evening | 7/Morning | 7/Evening
AIRHUM | 58 | 57 | 58 | 57 | 57 | 53 | 56 | 55 | 61 | 61 | 65 | 58 | 59 | 70
AIRTMP | 30 | 29 | 28 | 28 | 27 | 30 | 27 | 29 | 27 | 28 | 27 | 30 | 28 | 28
SOILMS | 667 | 116 | 368 | 241 | 288 | 303 | 346 | 366 | 340 | 369 | 387 | 389 | 420 | 433
SOILAF | 286 | 84 | 117 | 197 | 211 | 201 | 201 | 246 | 265 | 291 | 292 | 298 | 302 | 379
LGTLVL | 277 | 129 | 340 | 27 | 377 | 14 | 292 | 15 | 397 | 9 | 204 | 3 | 448 | 11
 | Fuzzy calculations
Rule 1 A | 1 | 0 | 0 | 0 | 0 | 0 | 0 | 0 | 0 | 0 | 0 | 0 | 0.2 | 0.33
Rule 1 B | 0.6 | 0.65 | 0.6 | 0.65 | 0.65 | 0.85 | 0.7 | 0.75 | 0.45 | 0.45 | 0.25 | 0.6 | 0.55 | 0
Rule 1 S | 0.6 | 0 | 0 | 0 | 0 | 0 | 0 | 0 | 0 | 0 | 0 | 0 | 0.2 | 0
Rule 2 A | 0 | 1 | 0.32 | 1 | 1 | 0.97 | 0.54 | 0.34 | 0.6 | 0.31 | 0.13 | 0.11 | 0 | 0
Rule 2 B | 0.6 | 0.65 | 0.6 | 0.65 | 0.65 | 0.85 | 0.7 | 0.75 | 0.45 | 0.45 | 0.25 | 0.6 | 0.55 | 0
Rule 2 S | 0 | 0.65 | 0.32 | 0.65 | 0.65 | 0.85 | 0.54 | 0.34 | 0.45 | 0.31 | 0.13 | 0.11 | 0 | 0
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
