Sirawit7205/Autoplanter/pictures/wifiTest.png

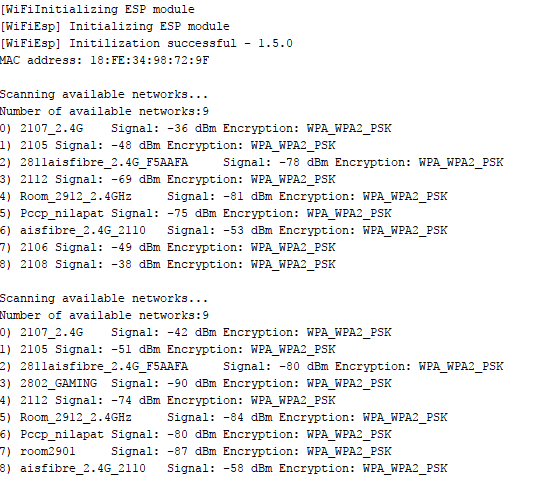
pictures/wifiTest.png
