Sirawit7205/Autoplanter/3d_version2/draft2.pdf

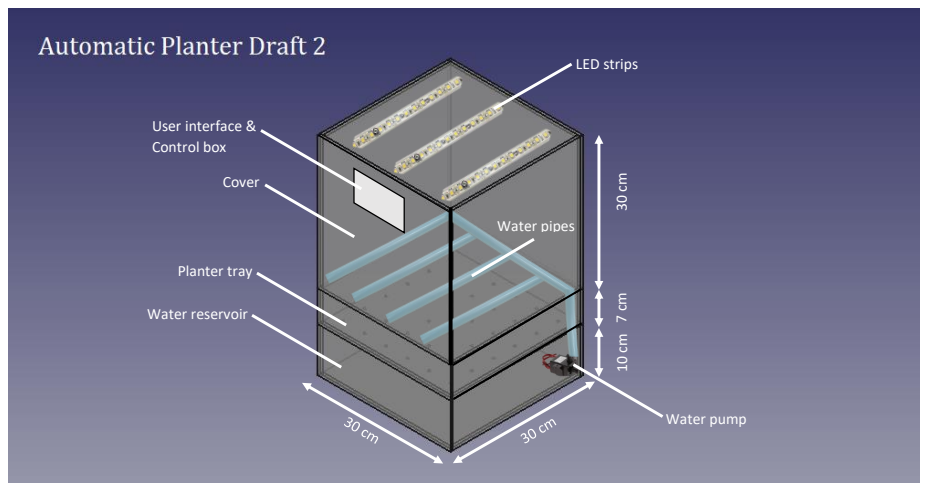
[picture p75: page 1]
Cover; Planter tray; Water reservoir; User interface & Control box; Water pipes; LED strips; Water pump
