Sirawit7205/Autoplanter/pcb/pcb.pdf

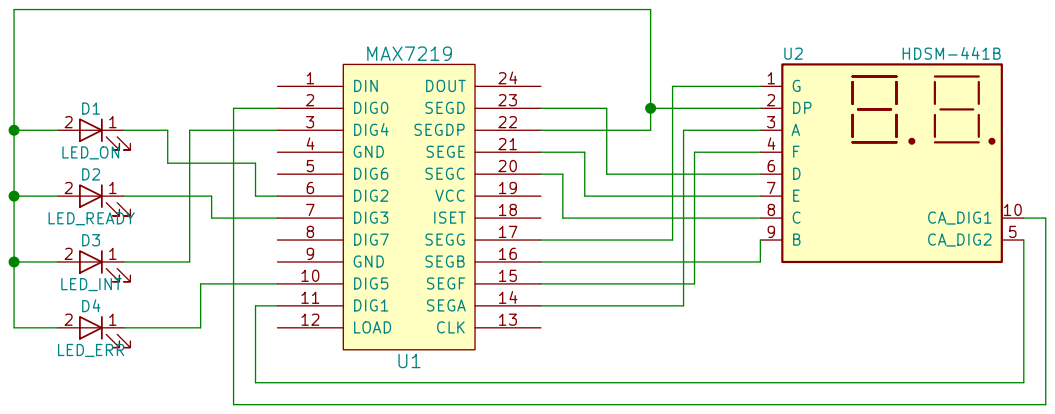
[picture p76: page 1]
