Sirawit7205/Autoplanter/(commit log)

2017-11-29 Initial commit, v.2.0
    [assemV2.FCStd, back.FCStd, base.FCStd, base_top.FCStd, complete.FCStd, drawer.FCStd, drawing_rail.FCStd, front_base.FCStd]
2017-12-03 Fixed Blynk init/runtime code, add schematics/PCB ver 1.20, add fuzzy logic rulesets, add measurement data
    [measurement_1week.xlsx]
2017-12-05 Code ver 3.0: Change Blynk configurations, add fuzzy control for pump and normal control for light
    [measurement_1week.xlsx]
2017-12-05 Fix: Reset lightCheck after cycle ends
    [autoPlanter.ino]
2017-12-09 Bugfix, add project report
    [autoPlanter.ino]
